Zayno/BitaxeFluxReview/_Manufacturing_Files/BitaxeFluxAstra_RevA_Manufacturing_BOM_updated.xlsx

Item | Reference Designators | Quantity | Value | Description | Manufacturer | Manufacturer Part Number | Package / Footprint | Mounting Type | Key Specification | LCSC Part Number | Digi-Key Part Number | Mouser Part Number | Lifecycle / Availability | Datasheet / Manufacturer Source | Notes | Supply Method / Consignment
1 | A1 | 1 | BM1373 | BM1373 ASIC | Bitmain | TBD – MANUAL VERIFICATION REQUIRED | BitaxeFluxAstra:BM1373 | SMD / thermal PTH-in-pad array | BM1373; custom 156-pad-object land pattern |  |  |  | Restricted/proprietary supply; approved source required | KiCad BOM / approved project design | ASSEMBLY INSTRUCTION: Customer will supply the BM1373 for placement at A1. Do not source or substitute this ASIC. Verify exact MPN, physical package/footprint, and received consignment inventory before scheduling assembly. | CONSIGNED - CUSTOMER SUPPLIED
2 | C2, C3, C8, C12, C24, C26, C38, C41, C49, C54, C55, C56, C57, C110, C111, C112, C113, C116, C117 | 19 | 10uF | Multilayer ceramic capacitor | Murata Electronics | GRM188R61E106KA73D | Capacitor_SMD:C_0603_1608Metric | SMD | 10µF ±10%, 25V, X5R, 0603 | C344022 | 490-18214-1-ND |  | Active; distributor listings verified | https://www.murata.com/en-us/products/productdetail?partno=GRM188R61E106KA73D | Original KiCad MPN and supplier identifiers retained; package/value/rating verified.
3 | C4, C16, C21, C27, C44, C45, C48, C199, C200 | 9 | 1uF | Multilayer ceramic capacitor | Taiyo Yuden | TMK107B7105KA-T | Capacitor_SMD:C_0603_1608Metric | SMD | 1µF ±10%, 25V, X7R, 0603 |  | 587-2984-1-ND |  | Active; distributor listing verified | https://www.digikey.com/en/products/result?keywords=TMK107B7105KA-T | Exact package and dielectric variant retained from KiCad BOM.
4 | C5, C31 | 2 | 4.7nF | Multilayer ceramic capacitor | Murata Electronics | GRM155R71E472KA01D | Capacitor_SMD:C_0402_1005Metric | SMD | 4.7nF ±10%, 25V, X7R, 0402 |  | 490-1309-1-ND |  | Active; manufacturer listing verified | https://www.murata.com/en-us/products/productdetail?partno=GRM155R71E472KA01D | Exact value, voltage, dielectric, and 0402 package verified.
5 | C6, C32 | 2 | 2.2nF | Multilayer ceramic capacitor | Murata Electronics | GRM155R61H222KA01D | Capacitor_SMD:C_0402_1005Metric | SMD | 2.2nF ±10%, 50V, X5R, 0402 |  | 490-8257-1-ND |  | Active; manufacturer listing verified | https://www.murata.com/en-us/products/productdetail?partno=GRM155R61H222KA01D | Original KiCad selection retained and verified.
6 | C7, C18, C33, C51, C52, C53, C92, C94 | 8 | 0.1uF | Multilayer ceramic capacitor | KYOCERA AVX | KGM05AR71C104KH | Capacitor_SMD:C_0402_1005Metric | SMD | 100nF ±10%, 16V, X7R, 0402 |  | 478-KGM05AR71C104KHCT-ND |  | Active; distributor listing verified | https://www.digikey.com/en/products/result?keywords=KGM05AR71C104KH | Original KiCad selection retained and verified.
7 | C9, C46 | 2 | 1000pF | Multilayer ceramic capacitor | Yageo | CC0805KRX7R9BB102 | Capacitor_SMD:C_0805_2012Metric | SMD | 1nF ±10%, 50V, X7R, 0805 |  | 311-1127-1-ND |  | Active; distributor listing verified | https://www.digikey.com/en/products/result?keywords=CC0805KRX7R9BB102 | Original KiCad selection retained and verified.
8 | C10, C11, C13, C14, C15, C102, C105, C107, C108, C109, C114, C115 | 12 | 100uF | Multilayer ceramic capacitor | Samsung Electro-Mechanics | CL31A107MQHNNNE | Capacitor_SMD:C_1206_3216Metric | SMD | 100µF ±20%, 6.3V, X5R, 1206 | C15008 | 1276-1782-1-ND |  | Active; distributor stock listed | https://www.digikey.com/en/products/detail/samsung-electro-mechanics/CL31A107MQHNNNE/3887440 | LCSC number completed from exact MPN; package/value/rating verified.
9 | C19, C40 | 2 | 4.7uF | Multilayer ceramic capacitor | Murata Electronics | GRM155R61A475MEAAD | Capacitor_SMD:C_0402_1005Metric | SMD | 4.7µF ±20%, 10V, X5R, 0402 |  | 490-14306-1-ND |  | Active; manufacturer/distributor listing verified | https://www.murata.com/en-us/products/productdetail?partno=GRM155R61A475MEAAD | Original KiCad selection retained and verified.
10 | C22, C37, C39, C42, C43 | 5 | 0.1uF | Multilayer ceramic capacitor | Murata Electronics | GRM155R71H104KE14D | Capacitor_SMD:C_0402_1005Metric | SMD | 100nF ±10%, 50V, X7R, 0402 | C77020 | 490-10700-1-ND |  | Active; manufacturer/distributor listing verified | https://www.murata.com/en-us/products/productdetail?partno=GRM155R71H104KE14D | Original KiCad MPN and supplier identifiers retained.
11 | C29, C30 | 2 | 33nF | Multilayer ceramic capacitor | Yageo | CC0402KRX7R9BB333 | Capacitor_SMD:C_0402_1005Metric | SMD | 33nF ±10%, 50V, X7R, 0402 | C106862 | 13-CC0402KRX7R9BB333CT-ND |  | Active; distributor listings verified | https://www.digikey.com/en/products/result?keywords=CC0402KRX7R9BB333 | Original KiCad selection retained and verified.
12 | C35, C36 | 2 | 22uF | Multilayer ceramic capacitor | Samsung Electro-Mechanics | CL21A226MPQNNNE | Capacitor_SMD:C_0805_2012Metric | SMD | 22µF ±20%, 10V, X5R, 0805 | C29277 | 1276-2910-1-ND |  | Active; distributor listings verified | https://www.digikey.com/en/products/result?keywords=CL21A226MPQNNNE | Original KiCad selection retained and verified.
13 | C47, C100, C103 | 3 | 33pF | Multilayer ceramic capacitor | KYOCERA AVX | KGM05ACG1E330JH | Capacitor_SMD:C_0402_1005Metric | SMD | 33pF ±5%, 25V, C0G/NP0, 0402 |  | 478-KGM05ACG1E330JHCT-ND |  | Active; distributor listing verified | https://www.digikey.com/en/products/result?keywords=KGM05ACG1E330JH | Original KiCad selection retained and verified.
14 | C63, C64, C65, C66, C67, C68, C69, C70, C71, C80, C81, C82, C83, C88, C89, C90 | 16 | 1uF | Multilayer ceramic capacitor | Taiyo Yuden | EMK105BJ105MV-F | Capacitor_SMD:C_0402_1005Metric | SMD | 1µF ±20%, 16V, X5R, 0402 | C2177690 | 587-5514-1-ND |  | Active; distributor listings verified | https://www.digikey.com/en/products/result?keywords=EMK105BJ105MV-F | Original KiCad selection retained and verified.
15 | C93 | 1 | 2.2nF C0G/NP0 | Precision multilayer ceramic capacitor | Murata Electronics | GRM1555C1H222JA01D | Capacitor_SMD:C_0402_1005Metric | SMD | 2.2nF ±5%, 50V, C0G/NP0, 0402 |  | 490-GRM1555C1H222JA01DCT-ND |  | Active; manufacturer/distributor listing verified | https://www.murata.com/en-us/products/productdetail?partno=GRM1555C1H222JA01D | Production MPN selected in place of original 'TBD / QUALIFY'; matches required value, C0G/NP0 dielectric, voltage class, tolerance, and footprint.
16 | C101 | 1 | 100pF | Multilayer ceramic capacitor | Yageo | CC0402JRNPO9BN101 | Capacitor_SMD:C_0402_1005Metric | SMD | 100pF ±5%, 50V, C0G/NP0, 0402 |  | 311-1024-1-ND |  | Active; distributor listing verified | https://www.digikey.com/en/products/result?keywords=CC0402JRNPO9BN101 | Original KiCad selection retained and verified.
17 | C104, C106 | 2 | 120uF | Conductive polymer hybrid aluminum capacitor | Nichicon | GYG1E121MCQ1GS | Capacitor_SMD:CP_Elec_6.3x5.9 | SMD polarized can | 120µF ±20%, 25V, 50mΩ ESR, 1.4A ripple, 6.3×5.8mm, 125°C |  | 493-GYG1E121MCQ1GSCT-ND |  | Mass production; active at Digi-Key | https://www.nichicon.com/en-us/part/gyg1e121mcq1gs/359/ | 25V GYG part selected to match the approved CAD requirement; 120µF, ±20%, 50mΩ ESR, 1.4A ripple, 6.3×5.8mm, 125°C. Footprint compatibility retained.
18 | FB1, FB2 | 2 | FerriteBead | Power-line ferrite bead | Murata Electronics | BLM31KN601SN1L | Capacitor_SMD:C_1206_3216Metric | SMD | 600Ω at 100MHz ±25%, 2.9A, 38mΩ max, 1206 | C668306 | 490-16533-1-ND | 81-BLM31KN601SN1L | Active; multiple distributor listings | https://www.murata.com/en-us/products/productdata/8801529331742/ENFA0091.pdf | Supplier identifiers completed from exact MPN.
19 | J1 | 1 | XT30UPB-M | XT30 vertical male PCB power connector | AMASS | XT30UPB-M | XT30UPB-M:AMASS_XT30UPB-M | THT | Male, vertical/straight PCB mount, 2 power contacts, 5.0mm pitch, 15A nominal | C428721 |  |  | Active/catalogued; LCSC/JLC listing verified | https://cdn.promelec.ru/upload/items/2025/03/25/AMASS_Catalogue_.pdf | Approved project connector identity applied consistently. Verify polarity marking and retention-hole plating in the assembly drawing before release.
20 | J2 | 1 | FPC-05F-30PH20 | 30-position FFC/FPC connector | XUNPU | FPC-05FB-30PH20 | BitaxeFluxAstra:FPC-SMD_30P-P0.50_XUNPU_FPC-05F-30PH20 | SMD, right-angle | 30 contacts, 0.5mm pitch, horizontal flip-lock, 0.3mm FFC, 50V/0.5A | C2856833 |  |  | In production; LCSC/JLC listing verified | https://www.xunpu.com.cn/product/413.html | The KiCad value/footprint label omits the 'B'; existing PARTNO FPC-05FB-30PH20 is the verified purchasable 30-pin 0.5mm right-angle part. No electrical grouping or connector substitution performed.
21 | J4 | 1 | USB_C_Receptacle_USB2.0 | USB Type-C receptacle for USB 2.0 | GCT | USB4105-GF-A | BitaxeFluxAstra:USB_C_Receptacle_GCT_USB4105-xx-A | SMD, top-mount | USB-C receptacle, USB 2.0, 16 contacts, horizontal mating |  | 2073-USB4105-GF-ACT-ND |  | Active; Digi-Key and Mouser listings verified | https://www.digikey.com/en/products/detail/gct/USB4105-GF-A/11198441 | Exact -GF-A suffix and footprint family retained.
22 | J7, J8, J9 | 3 | Conn_01x04 | 4-position fan/header connector | Molex | 0470531000 | BitaxeFluxAstra:470531000 | THT, vertical | 4 circuits, 2.54mm pitch, vertical male header with friction lock |  | WM4330-ND |  | Active; manufacturer/distributor listing verified | https://www.molex.com/content/dam/molex/molex-dot-com/products/automated/en-us/salesdrawingpdf/470/47053/470531000_sd.pdf | Connector position count, pitch, orientation, and THT mounting verified.
23 | L1, L4 | 2 | 270nH | High-current shielded power inductor | Coilcraft | SLC1175-271MEC | BitaxeFluxAstra:SLC1175-271MEC_COC | SMD | 270nH ±20%, shielded, 35.5A current rating, SLC1175 package |  |  | 994-SLC1175-271MEC | Active; manufacturer/Mouser listing verified | https://www.coilcraft.com/en-us/products/power/shielded-inductors/low-dcr/slc/slc1175/ | Exact 270nH MPN and custom footprint retained.
24 | L2, L3 | 2 | 1.5uH | Shielded power inductor | cjiang (Changjiang Microelectronics Technology) | FTC201612S1R5MBCA | BitaxeFluxAstra:IND-SMD_L2.0-W1.6 | SMD | 1.5µH ±20%, 4A, 40mΩ, 2.0×1.6mm | C5832350 |  |  | Active/in stock at LCSC | https://www.lcsc.com/product-detail/Power-Inductors_cjiang-Changjiang-Microelectronics-Tech-FTC201612S1R5MBCA_C5832350.html | Exact MPN, value, current rating, and land size verified.
25 | R1, R10 | 2 | 49.9 | Thick-film chip resistor | Yageo | RC0402FR-0749R9L | Resistor_SMD:R_0402_1005Metric | SMD | 49.9Ω ±1%, 0.063W, 0402 |  | 311-49.9LRCT-ND |  | Active; distributor listing verified | https://www.digikey.com/en/products/result?keywords=RC0402FR-0749R9L | Original KiCad selection retained and verified.
26 | R2, R21 | 2 | 1 | High-power chip resistor | ROHM Semiconductor | ESR10EZPJ1R0 | Resistor_SMD:R_0805_2012Metric | SMD | 1Ω ±5%, high-power ESR10 series, 0805 |  | RHM1KTR-ND |  | Active; distributor listing verified | https://www.digikey.com/en/products/result?keywords=ESR10EZPJ1R0 | Exact ROHM ESR10 package/value variant retained.
27 | R3, R19 | 2 | 10 | Thick-film chip resistor | Yageo | RC0402FR-0710RL | Resistor_SMD:R_0402_1005Metric | SMD | 10Ω ±1%, 0.063W, 0402 |  | 311-10.0LRCT-ND |  | Active; distributor listing verified | https://www.digikey.com/en/products/result?keywords=RC0402FR-0710RL | Original KiCad selection retained and verified.
28 | R5, R6, R13, R16, R20, R24, R30, R37, R38, R40, R57 | 11 | 10k | Thick-film chip resistor | Yageo | RC0402FR-0710KL | Resistor_SMD:R_0402_1005Metric | SMD | 10kΩ ±1%, 0.063W, 0402 | C60490 | 311-10.0KLRCT-ND |  | Active; distributor listings verified | https://www.digikey.com/en/products/detail/yageo/RC0402FR-0710KL/729470 | Updated supplier identifiers to match the approved Yageo RC0402FR-0710KL 10kΩ ±1% 0402 selection; includes R37.
29 | R12 | 1 | 30.9k | Thick-film chip resistor | Yageo | RC0402FR-0730K9L | Resistor_SMD:R_0402_1005Metric | SMD | 30.9kΩ ±1%, 0.063W, 0402 | C185428 | YAG3110CT-ND |  | Active; distributor listings verified | https://www.digikey.com/en/products/result?keywords=RC0402FR-0730K9L | Original KiCad selection retained and verified.
30 | R14, R25 | 2 | 5.1k | Thick-film chip resistor | Stackpole Electronics | RMCF0402JT5K10 | Resistor_SMD:R_0402_1005Metric | SMD | 5.1kΩ ±5%, 0.063W, 0402 | C2481753 | RMCF0402JT5K10CT-ND |  | Active; distributor listings verified | https://www.digikey.com/en/products/result?keywords=RMCF0402JT5K10 | Original KiCad selection retained and verified.
31 | R15 | 1 | 13.7k | Thick-film chip resistor | Yageo | RC0402FR-0713K7L | Resistor_SMD:R_0402_1005Metric | SMD | 13.7kΩ ±1%, 0.063W, 0402 | C274888 | 311-13.7KLRCT-ND |  | Active; distributor listings verified | https://www.digikey.com/en/products/result?keywords=RC0402FR-0713K7L | Original KiCad selection retained and verified.
32 | R17 | 1 | 52.3k | Thick-film chip resistor | Yageo | RC0402FR-0752K3L | Resistor_SMD:R_0402_1005Metric | SMD | 52.3kΩ ±1%, 0.063W, 0402 |  | YAG3179CT-ND |  | Active; distributor listing verified | https://www.digikey.com/en/products/result?keywords=RC0402FR-0752K3L | Original KiCad selection retained and verified.
33 | R23 | 1 | 20k | Thick-film chip resistor | Yageo | RC0402FR-0720KL | Resistor_SMD:R_0402_1005Metric | SMD | 20kΩ ±1%, 0.063W, 0402 |  | 311-20.0KLRCT-ND |  | Active; distributor listing verified | https://www.digikey.com/en/products/result?keywords=RC0402FR-0720KL | Original KiCad selection retained and verified.
34 | R26, R48 | 2 | 1k | Thick-film chip resistor | Yageo | RC0402FR-071KL | Resistor_SMD:R_0402_1005Metric | SMD | 1kΩ ±1%, 0.063W, 0402 |  | 311-1.00KLRCT-ND |  | Active; distributor listing verified | https://www.digikey.com/en/products/result?keywords=RC0402FR-071KL | Original KiCad selection retained and verified.
35 | R29, R32, R49, R56 | 4 | 0 | Zero-ohm chip jumper | Yageo | RC0402JR-070RL | Resistor_SMD:R_0402_1005Metric | SMD | 0Ω jumper, 0.063W, 0402 |  | 311-0.0JRCT-ND |  | Active; distributor listing verified | https://www.digikey.com/en/products/result?keywords=RC0402JR-070RL | R49 added as the populated CORE_EN 0Ω link; same Yageo RC0402JR-070RL 0402 jumper used by the existing group.
36 | R31 | 1 | 5.6k | Thick-film chip resistor | Yageo | RC0402FR-075K6L | Resistor_SMD:R_0402_1005Metric | SMD | 5.6kΩ ±1%, 0.063W, 0402 |  | 311-5.6KLRCT-ND |  | Active; distributor listing verified | https://www.digikey.com/en/products/result?keywords=RC0402FR-075K6L | Original KiCad selection retained and verified.
37 | R39 | 1 | 4.7k | Thick-film chip resistor | Yageo | RC0402JR-074K7L | Resistor_SMD:R_0402_1005Metric | SMD | 4.7kΩ ±5%, 0.063W, 0402 |  | 311-4.7KJRCT-ND |  | Active; distributor listing verified | https://www.digikey.com/en/products/result?keywords=RC0402JR-074K7L | Original KiCad selection retained and verified.
38 | R45, R47 | 2 | 4.7k | Precision thick-film chip resistor | Yageo | RC0402DR-074K7L | Resistor_SMD:R_0402_1005Metric | SMD | 4.7kΩ ±0.5%, 0.063W, 0402 | C471788 | 13-RC0402DR-074K7LCT-ND |  | Active; availability should be checked at release | https://www.digikey.com/en/products/detail/yageo/RC0402DR-074K7L/5917421 | Corrected selection: original MPN RC0402DR-0710KL and LCSC C471764 are 10kΩ and do not match the 4.7kΩ schematic value. Replacement preserves the DR 0.5% tolerance class and 0402 package.
39 | R58, R59 | 2 | 22 | Thick-film chip resistor | Yageo | RC0402FR-0722RL | Resistor_SMD:R_0402_1005Metric | SMD | 22Ω ±1%, 0.063W, 0402 |  |  |  | Active; manufacturer/distributor listing verified | https://www.digikey.com/en/products/result?keywords=RC0402FR-0722RL | USB series resistors; exact value/package MPN verified.
40 | SW1, SW2 | 2 | SW_Push_SPST_NO | Momentary tactile switch | CIT Relay and Switch | CS1213AGF260 | BitaxeFluxAstra:SW_CS1213AGF260_CRS | SMD, top-actuated | SPST-NO, momentary, 50mA at 50VDC, 260gf | C5578986 | 2449-CS1213AGF260CT-ND |  | Active; distributor listings verified | https://www.digikey.com/en/products/detail/cit-relay-and-switch/CS1213AGF260/16607763 | Exact actuator force, contact form, and footprint family verified.
41 | U2 | 1 | SN74AXC4T774 | 4-bit dual-supply level translator | Texas Instruments | SN74AXC4T774PWR | Package_SO:TSSOP-16_4.4x5mm_P0.65mm | SMD | 4-channel direction-controlled translator, 0.65mm TSSOP-16 | C1849453 | 296-SN74AXC4T774PWRCT-ND |  | Active; TI product status verified | https://www.ti.com/product/SN74AXC4T774 | Exact PWR TSSOP-16 suffix and pin-count compatibility verified.
42 | U3, U7 | 2 | TPS546D24S | 40A PMBus synchronous buck power stage/controller | Texas Instruments | TPS546D24SRVFR | BitaxeFluxAstra:LQFN40-CLIP | SMD | 2.95–16V input, 40A, PMBus, RVF LQFN-CLIP 40-pin |  | 296-TPS546D24SRVFRCT-ND |  | Active; TI product status verified | https://www.ti.com/product/TPS546D24S/part-details/TPS546D24SRVFR | Exact RVFR package/tape suffix and custom footprint pin count verified.
43 | U4, U5 | 2 | TPS62933DRLR | 3A synchronous step-down converter | Texas Instruments | TPS62933DRLR | BitaxeFluxAstra:SOT-583-8_L2.1-W1.2-P0.50-LS1.6-BR | SMD | 3.8–30V input, 3A, fixed-frequency buck, SOT-583 8-pin | C3200405 | 296-TPS62933DRLRCT-ND |  | Active; TI product status verified | https://www.ti.com/product/TPS62933/part-details/TPS62933DRLR | Exact DRLR SOT-583-8 package variant verified.
44 | U6 | 1 | ESP32-S3-WROOM-1-N16R8 | Wi-Fi/Bluetooth LE MCU module | Espressif Systems | ESP32-S3-WROOM-1-N16R8 | BitaxeFluxAstra:ESP32-S3-WROOM-1 | SMD module | ESP32-S3 module, 16MB flash, 8MB octal PSRAM, PCB antenna |  | 5407-ESP32-S3-WROOM-1-N16R8TR-ND |  | Active; manufacturer documentation verified | https://documentation.espressif.com/esp32-s3-wroom-1_wroom-1u_datasheet_en.pdf | Exact N16R8 memory variant and PCB-antenna module footprint verified.
45 | U8 | 1 | 25MHz | CMOS oscillator | Shenzhen SCTF Electronics | SX3M25.000E20F30THN | BitaxeFluxAstra:SMD3225-4P | SMD | 25MHz, 1.2V, CMOS, ±20ppm initial, 3.2×2.5mm 4-pad | C5137262 | 5852-SX3M25.000E20F30THNTR-ND |  | Active/stocked distributor listings verified | https://www.digikey.com/en/products/detail/shenzhen-sctf-electronics/SX3M25-000E20F30THN/25573861 | Exact frequency, supply variant, output type, and 3225 package verified.
46 | U10 | 1 | TLV77308PDBVR | 300mA low-dropout regulator | Texas Instruments | TLV77308PDBVR | Package_TO_SOT_SMD:SOT-23-5 | SMD | Fixed 0.8V output, 300mA, SOT-23-5 |  | 296-TLV77308PDBVRCT-ND |  | Active; TI product status verified | https://www.ti.com/product/TLV773/part-details/TLV77308PDBVR | Exact 0.8V PDBVR fixed-output variant verified.
47 | U11 | 1 | TLV77312PDBVR | 300mA low-dropout regulator | Texas Instruments | TLV77312PDBVR | Package_TO_SOT_SMD:SOT-23-5 | SMD | Fixed 1.2V output, 300mA, SOT-23-5 |  | 296-TLV77312PDBVRCT-ND |  | Active; TI product status verified | https://www.ti.com/product/TLV773/part-details/TLV77312PDBVR | Exact 1.2V PDBVR fixed-output variant verified.
48 | U13 | 1 | EMC2103-2-AP-TR | Fan controller and remote temperature monitor | Microchip Technology | EMC2103-2-AP-TR | Package_DFN_QFN:QFN-16-1EP_4x4mm_P0.65mm_EP2.1x2.1mm | SMD | SMBus fan controller, remote-diode monitor, QFN-16 exposed pad |  | 150-EMC2103-2-AP-CT-ND |  | In production; manufacturer datasheet verified | https://ww1.microchip.com/downloads/en/DeviceDoc/20005250.pdf | Exact -2-AP-TR electrical/package variant and QFN-16 pin count verified.
49 | U16 | 1 | AP2502KTR-G1 | Four-channel constant-current LED sink | Diodes Incorporated | AP2502KTR-G1 | Package_TO_SOT_SMD:SOT-23-6 | SMD | 4-channel constant-current sink, SOT-23-6, -40°C to +85°C |  | AP2502KTR-G1DICT-ND |  | Active; manufacturer product page verified | https://www.diodes.com/part/view/AP2502 | Exact KTR-G1 SOT-23-6 suffix retained and verified.
50 | R51 | 1 | 31.6k | Thick-film chip resistor | Yageo | RC0402FR-0731K6L | Resistor_SMD:R_0402_1005Metric | SMD | 31.6kΩ ±1%, 0.063W, 0402 | C276265 | YAG3115CT-ND |  | Active; distributor listings verified | https://www.digikey.com/en/products/detail/yageo/RC0402FR-0731K6L/5281980 | Populated U3 VSEL programming resistor from U3_VSEL to AGND1 for the approved 1.00V nominal core boot target.
