Zayno/BitaxeFluxReview/_KiCad_Project/3d/XT30PW-M--3DModel-STEP-269445.STEP

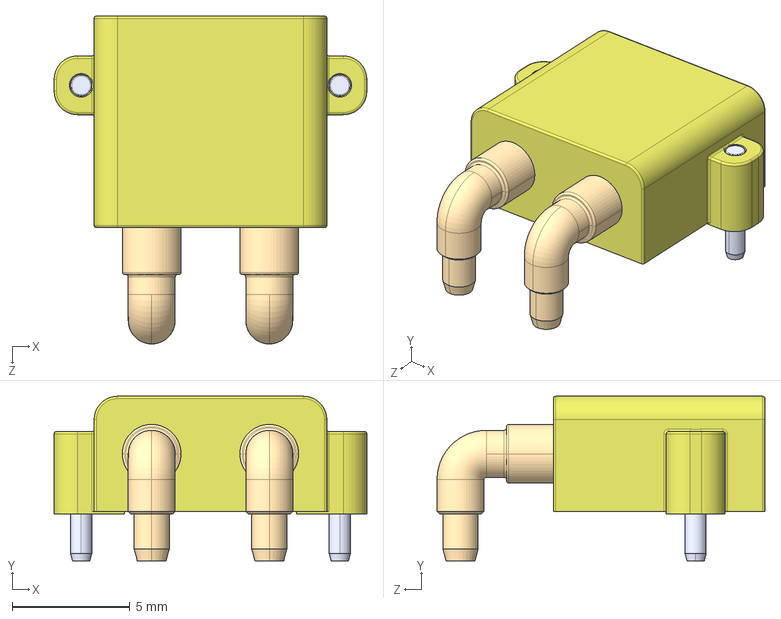
[picture p1: CAD file, 2026-10-25]
_KiCad_Project/3d/XT30PW-M--3DModel-STEP-269445.STEP
13.3 x 7.00 x 14.0 mm
