Zayno/BitaxeFluxReview/_KiCad_Project/BitaxeFluxAstra.step

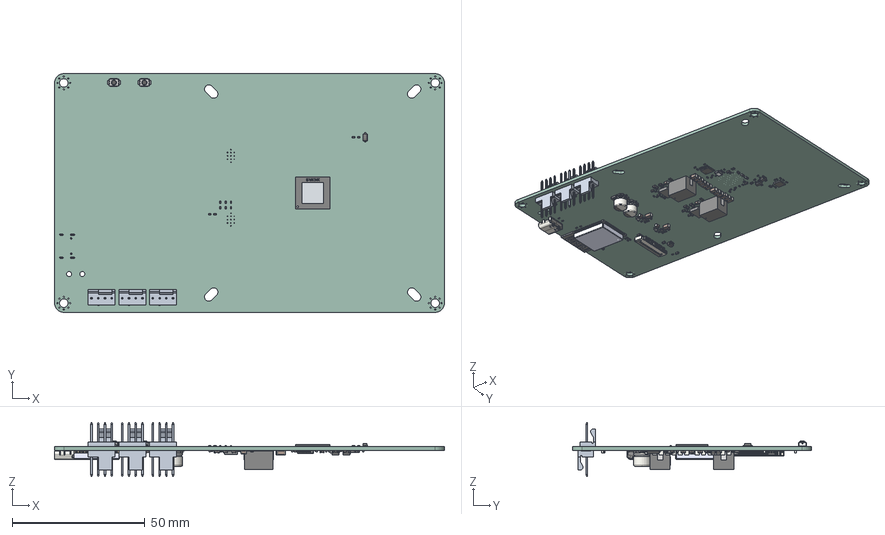
[picture p2: CAD file, 2026-10-25]
_KiCad_Project/BitaxeFluxAstra.step
147.0 x 90.0 x 20.5 mm
D_SOD_123F
R_0402_1005Metric x 42
Sketch002
Sketch003
C_1206_3216Metric x 14
C_0603_1608Metric x 28
C_0402_1005Metric x 44
C_0805_2012Metric x 4
SOT-583-8_L2.1-W1.2-P0.50-LS1.6-BR x 2
ECS-327KE
IND-SMD_L2.0-W1.6-H1.1 x 2
TSSOP-16_4.4x5mm_P0.65mm
RVF40 x 2
R_0805_2012Metric x 2
CP_Elec_63x59 x 2
SOT-23-6
SOT-23-5 x 2
USB_C_Receptacle_16P_TopMnt_Horizontal_GCT_USB4105-xx-A
ESP32-S3-WROOM-1-N8R2
QFN-16-1EP_4x4mm_P0.65mm_EP2.1x2.1mm
FPC-SMD_30P-P0.50_XUNPU_FPC-05F-30PH20
Bit9F3C_PCB
