Zayno/BitaxeFluxReview/_KiCad_Project/3d/SOT-583-8_L2.1-W1.2-P0.50-LS1.6-BR.step

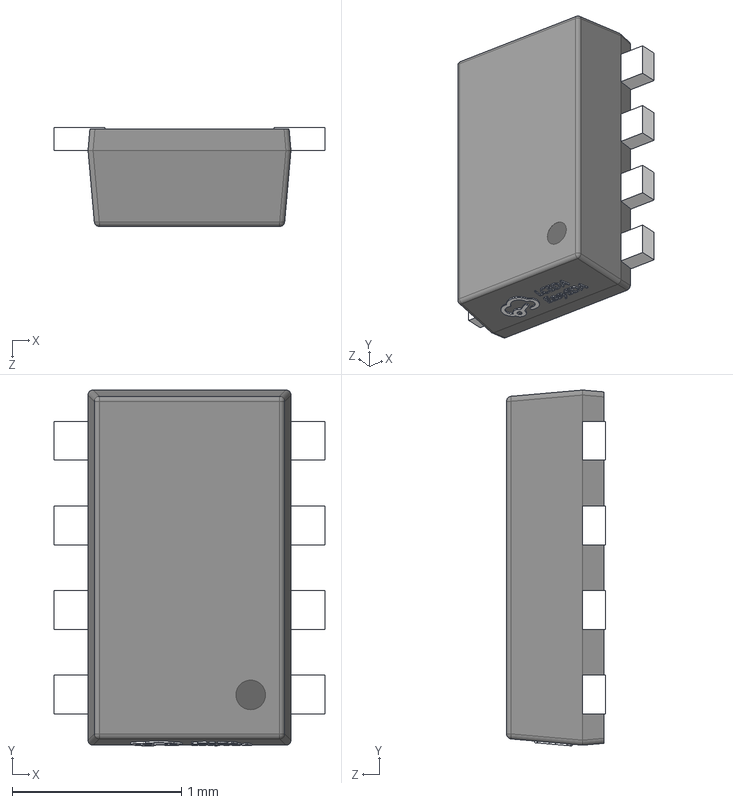
[picture p3: CAD file, 2026-10-25]
_KiCad_Project/3d/SOT-583-8_L2.1-W1.2-P0.50-LS1.6-BR.step
1.60 x 2.10 x 0.585 mm
