Zayno/BitaxeFluxReview/_KiCad_Project/3d/TPS546D24ARVFR.step

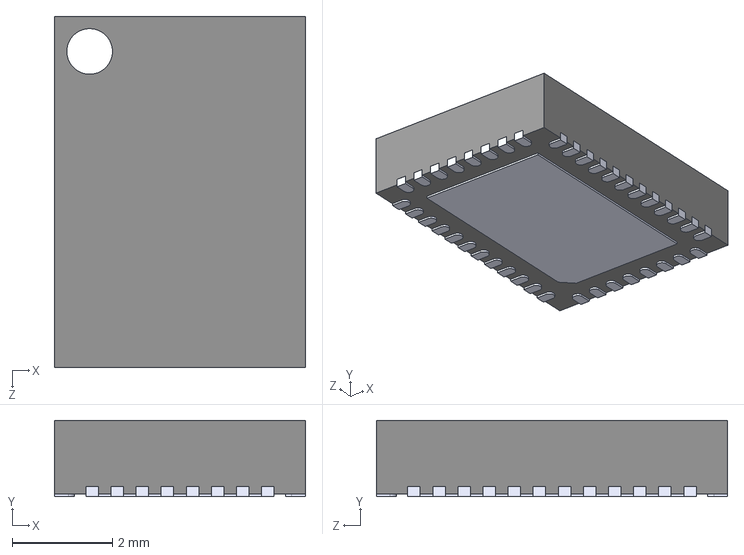
[picture p4: CAD file, 2026-10-25]
_KiCad_Project/3d/TPS546D24ARVFR.step
5.00 x 1.52 x 7.00 mm
