Zayno/BitaxeFluxReview/_KiCad_Project/3d/IND-SMD_L2.0-W1.6-H1.1.step

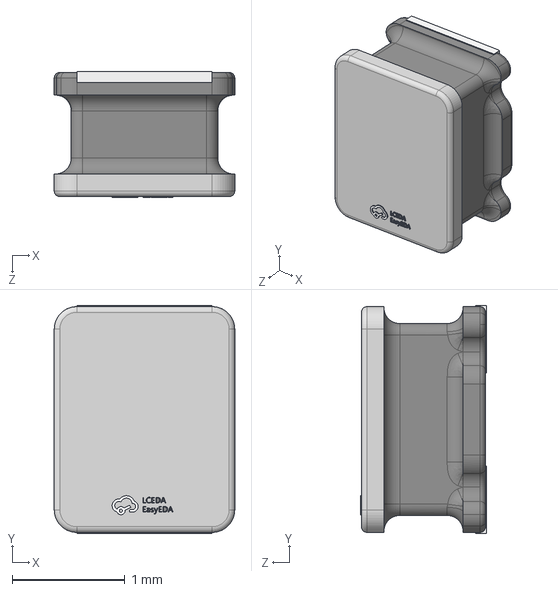
[picture p5: CAD file, 2026-10-25]
_KiCad_Project/3d/IND-SMD_L2.0-W1.6-H1.1.step
1.60 x 2.02 x 1.12 mm
