Zayno/BitaxeFluxReview/_KiCad_Project/3d/XT30UPB-M--3DModel-STEP-510211.STEP

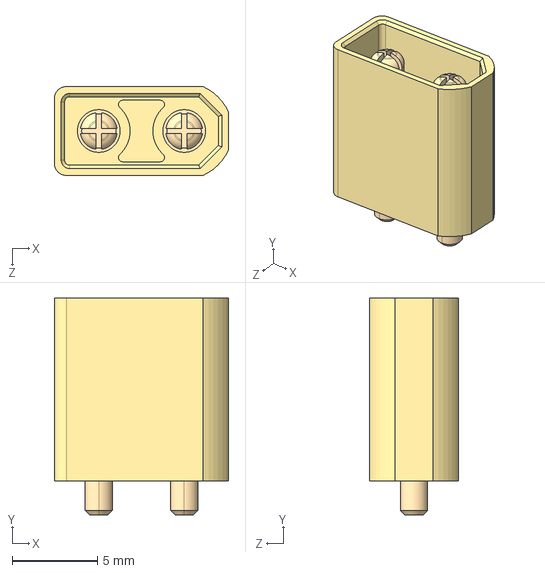
[picture p6: CAD file, 2026-10-25]
_KiCad_Project/3d/XT30UPB-M--3DModel-STEP-510211.STEP
10.2 x 12.7 x 5.20 mm
