Zayno/BitaxeFluxReview/_KiCad_Project/3d/FPC-SMD_30P-P0.50_XUNPU_FPC-05F-30PH20.step

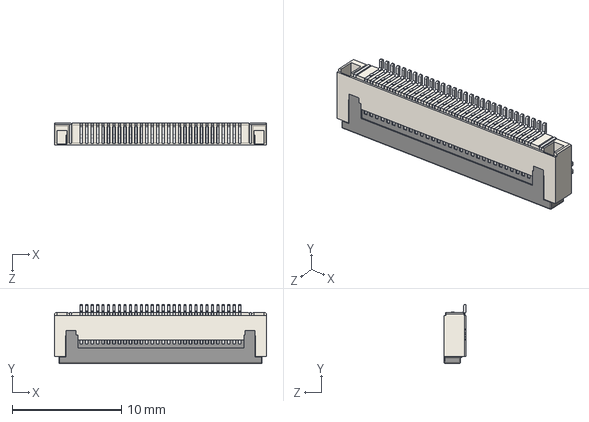
[picture p7: CAD file, 2026-10-25]
_KiCad_Project/3d/FPC-SMD_30P-P0.50_XUNPU_FPC-05F-30PH20.step
19.4 x 5.40 x 2.00 mm
