Zayno/BitaxeFluxReview/_KiCad_Project/3d/BM1373.step

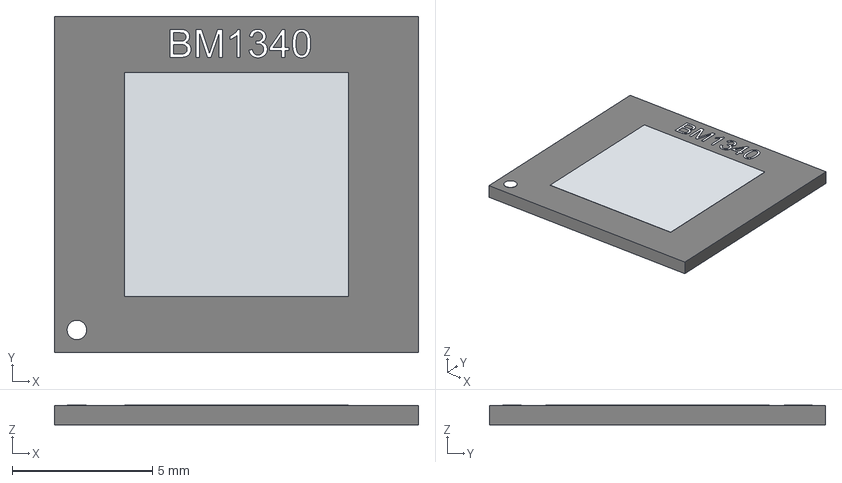
[picture p8: CAD file, 2026-10-25]
_KiCad_Project/3d/BM1373.step
13.0 x 12.0 x 0.71 mm
Sketch002
Sketch003
