Zayno/BitaxeFluxReview/_KiCad_Project/3d/CS1213AG-tr.stp

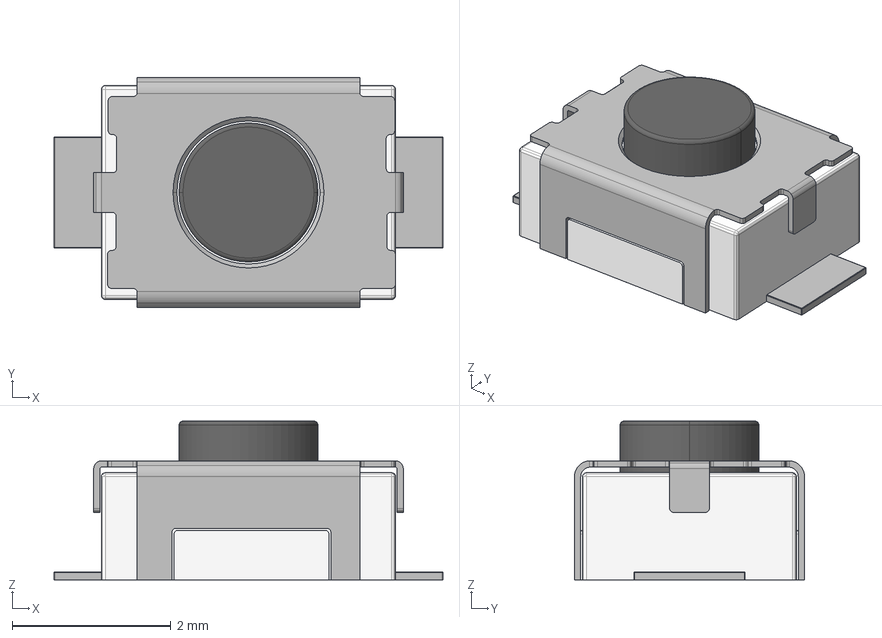
[picture p9: CAD file, 2026-10-25]
_KiCad_Project/3d/CS1213AG-tr.stp
4.90 x 2.90 x 2.00 mm
