Zayno/BitaxeFluxReview/_KiCad_Project/3d/oscillator3.2x2.5.step

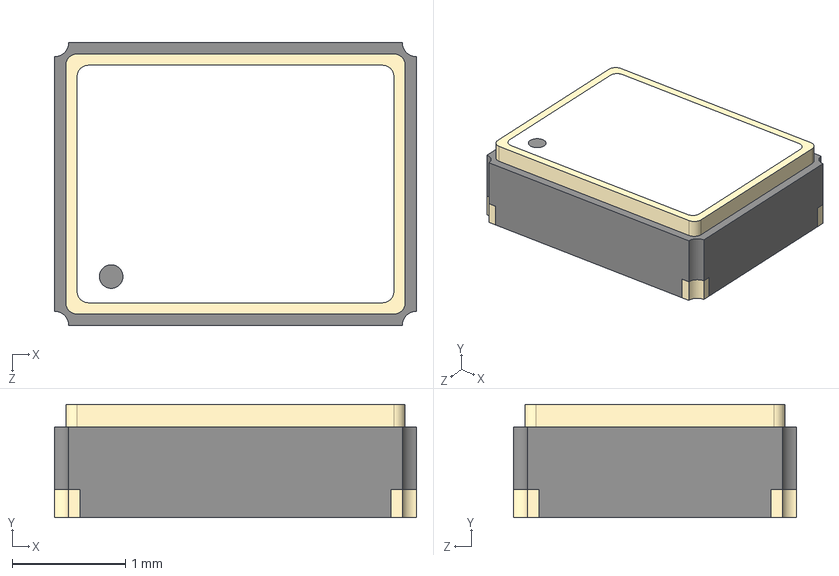
[picture p10: CAD file, 2026-10-25]
_KiCad_Project/3d/oscillator3.2x2.5.step
3.20 x 1.00 x 2.50 mm
