Zayno/BitaxeFluxReview/_KiCad_Project/3d/470531000.stp

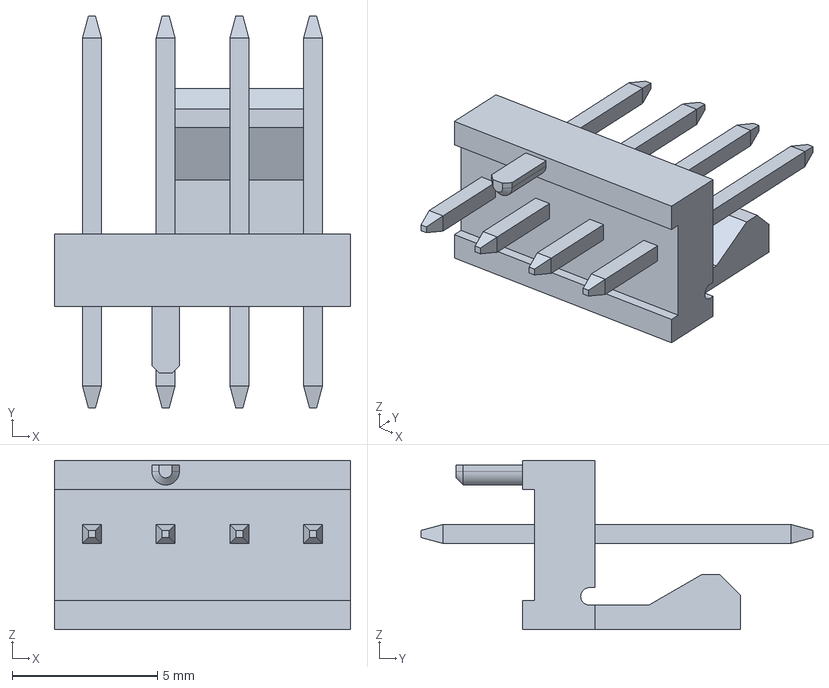
[picture p12: CAD file, 2026-10-25]
_KiCad_Project/3d/470531000.stp
10.2 x 13.5 x 5.84 mm
