Zayno/BitaxeFluxReview/_KiCad_Project/pdf/BitaxeFluxAstra.pdf

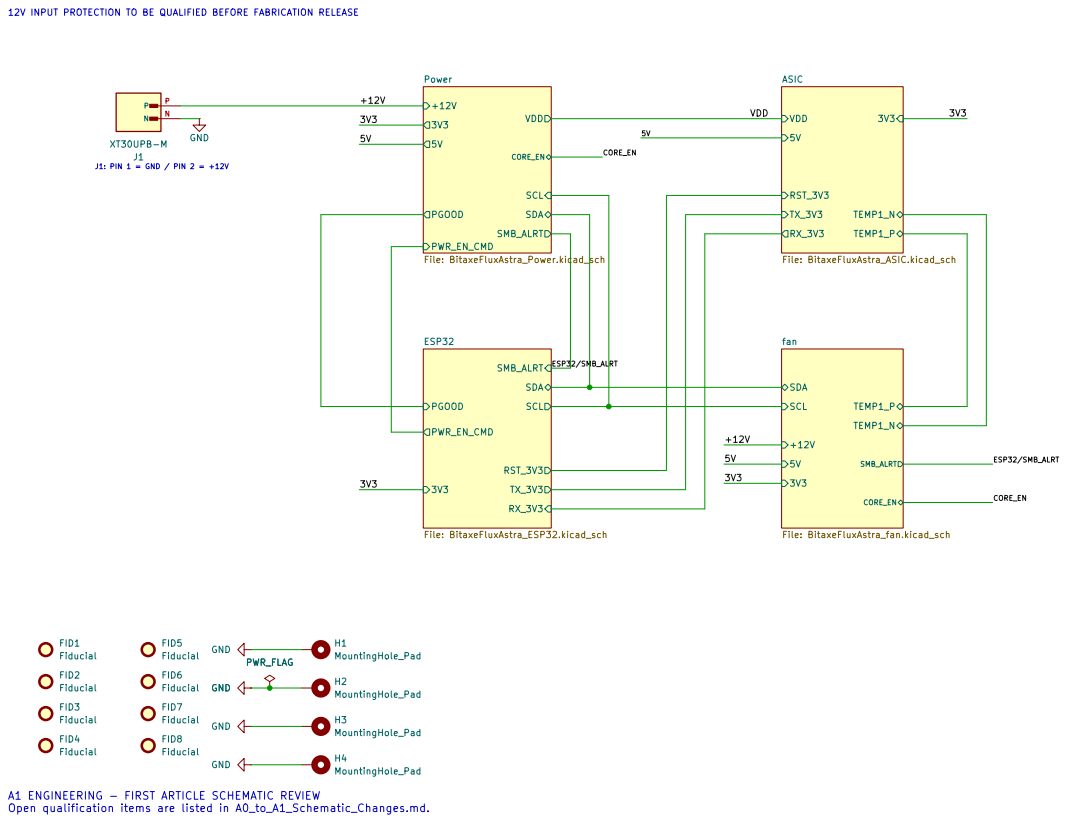
[picture p13: page 1]

J1: PIN 1 = GND / PIN 2 = +12V A1 ENGINEERING - FIRST ARTICLE SCHEMATIC REVIEW

12V INPUT PROTECTION TO BE QUALIFIED BEFORE FABRICATION RELEASE

File: BitaxeFluxAstra_fan.kicad_sch SDA SCL SMB_ALRT PGOOD

Open qualification items are listed in A0_to_A1_Schematic_Changes.md.

A1 ENGINEERING - FIRST ARTICLE SCHEMATIC REVIEW
bitaxeorg
Sheet: /
File: BitaxeFluxAstra.kicad_sch
Title: Bitaxe Flux Astra

Size: A3 | Rev: RevA | F Date: 2026-09-20
KiCad E.D.A. 10.0.5 | Id: 1/5

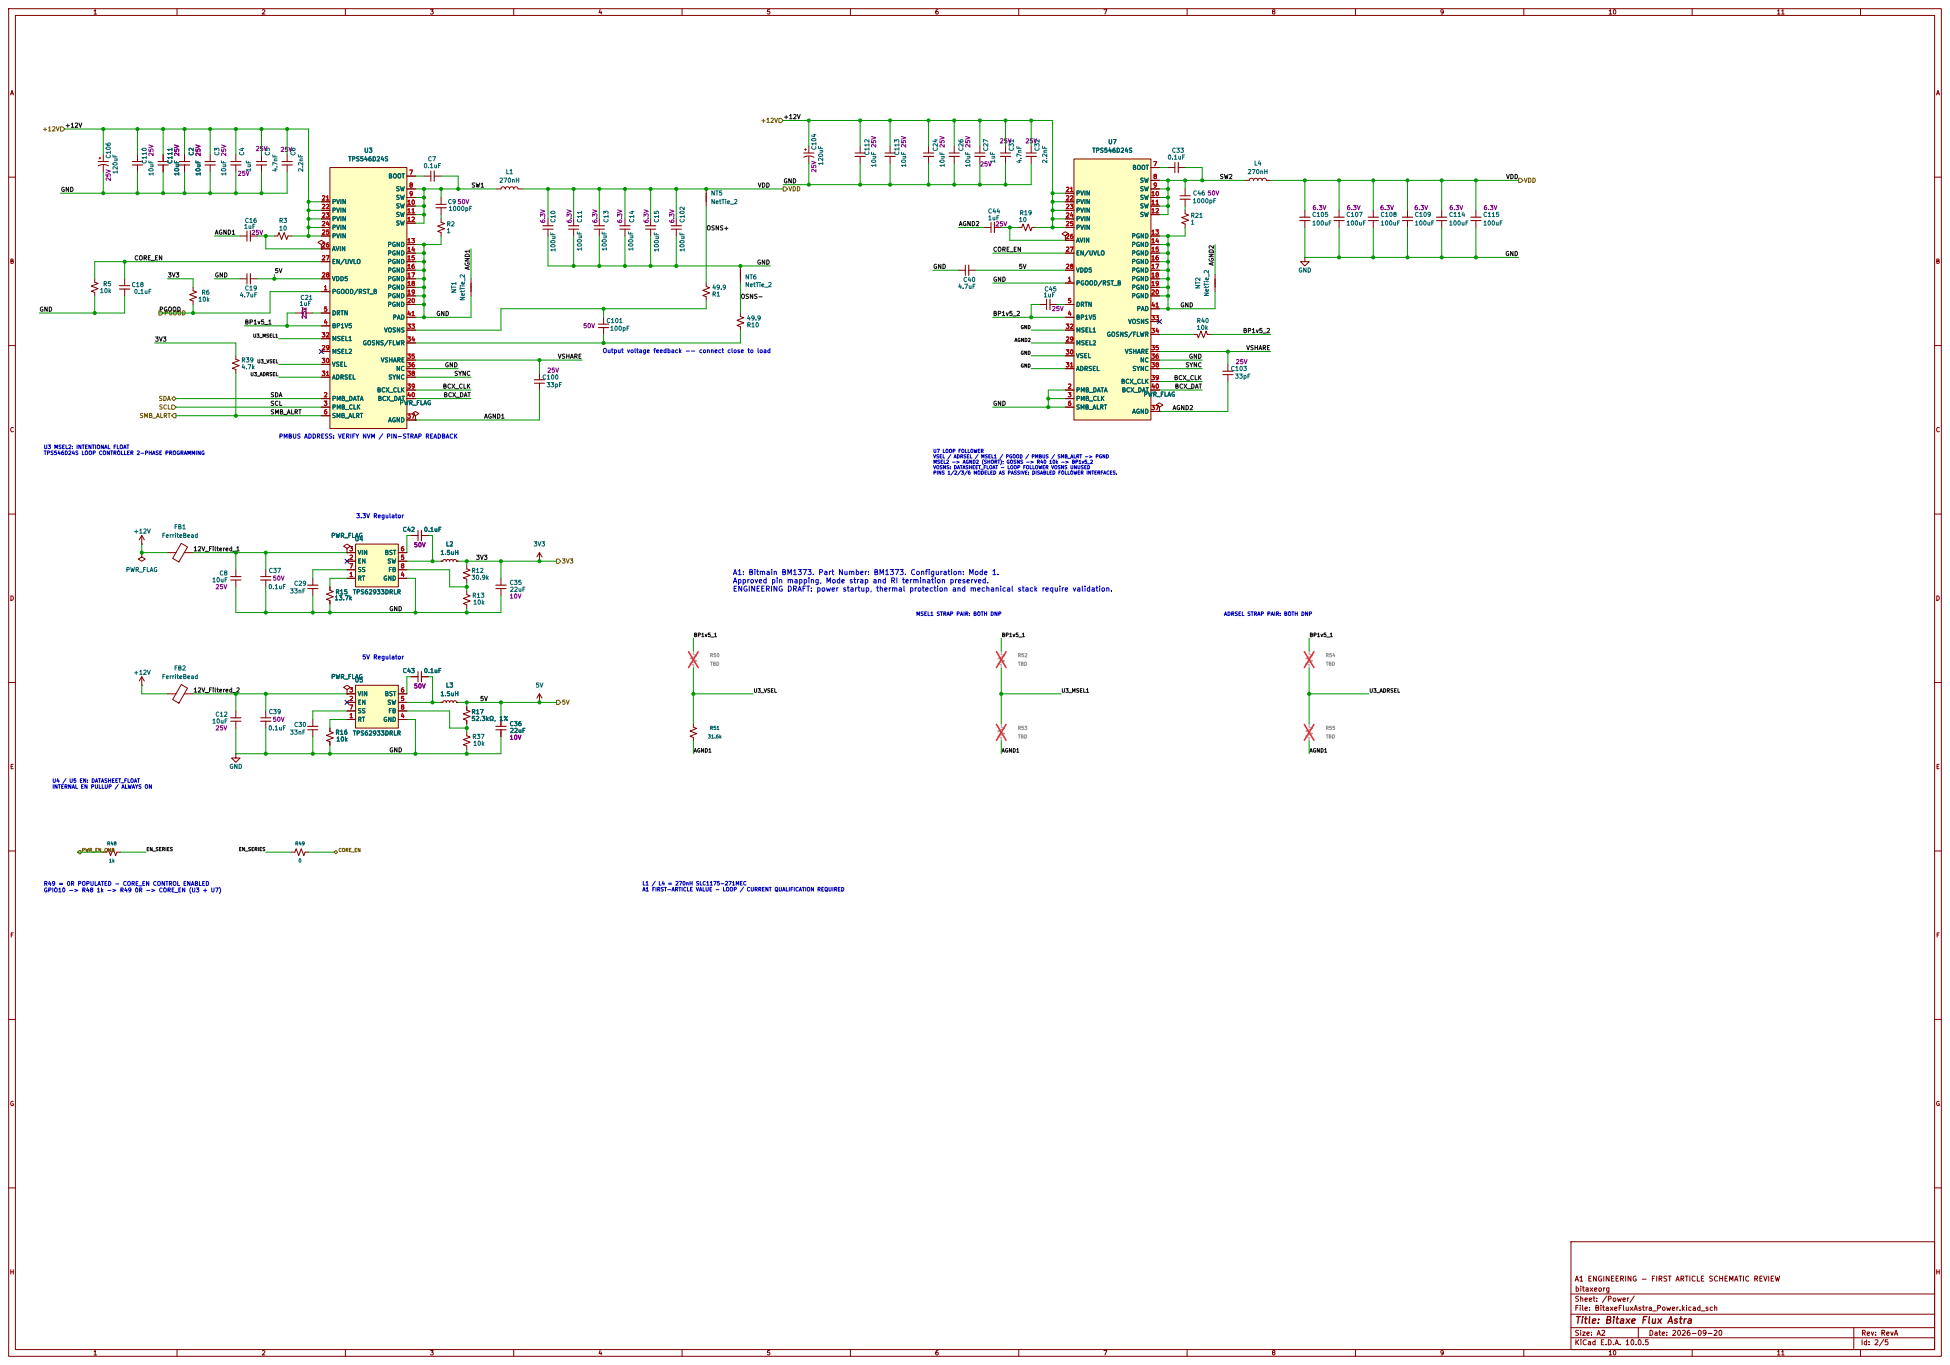
[picture p14: page 2]

SW 12 PGND 13 PGND 14 PGND 15 PGND 16 PGND 17 PGND 18 PGND 19 PGND 20 PVIN 21 PVIN 22 PVIN 23 PVIN 24 PVIN 25
GND CORE_EN

U3 MSEL2: INTENTIONAL FLOAT
TPS546D24S LOOP CONTROLLER 2-PHASE PROGRAMMING

U7 LOOP FOLLOWER
VSEL / ADRSEL / MSEL1 / PGOOD / PMBUS / SMB_ALRT -> PGND MSEL2 -> AGND2 (SHORT); GOSNS -> R40 10k -> BP1v5_2

VOSNS: DATASHEET_FLOAT - LOOP FOLLOWER VOSNS UNUSED

ENGINEERING DRAFT: power startup, thermal protection and mechanical stack require validation. U4
VIN 3

Approved pin mapping, Mode strap and RI termination preserved.

GPIO10 -> R48 1k -> R49 0R -> CORE_EN (U3 + U7) U4 / U5 EN: DATASHEET_FLOAT
INTERNAL EN PULLUP / ALWAYS ON

L1 / L4 = 270nH SLC1175-271MEC
A1 FIRST-ARTICLE VALUE - LOOP / CURRENT QUALIFICATION REQUIRED

A1 ENGINEERING - FIRST ARTICLE SCHEMATIC REVIEW
bitaxeorg
Sheet: /Power/
File: BitaxeFluxAstra_Power.kicad_sch

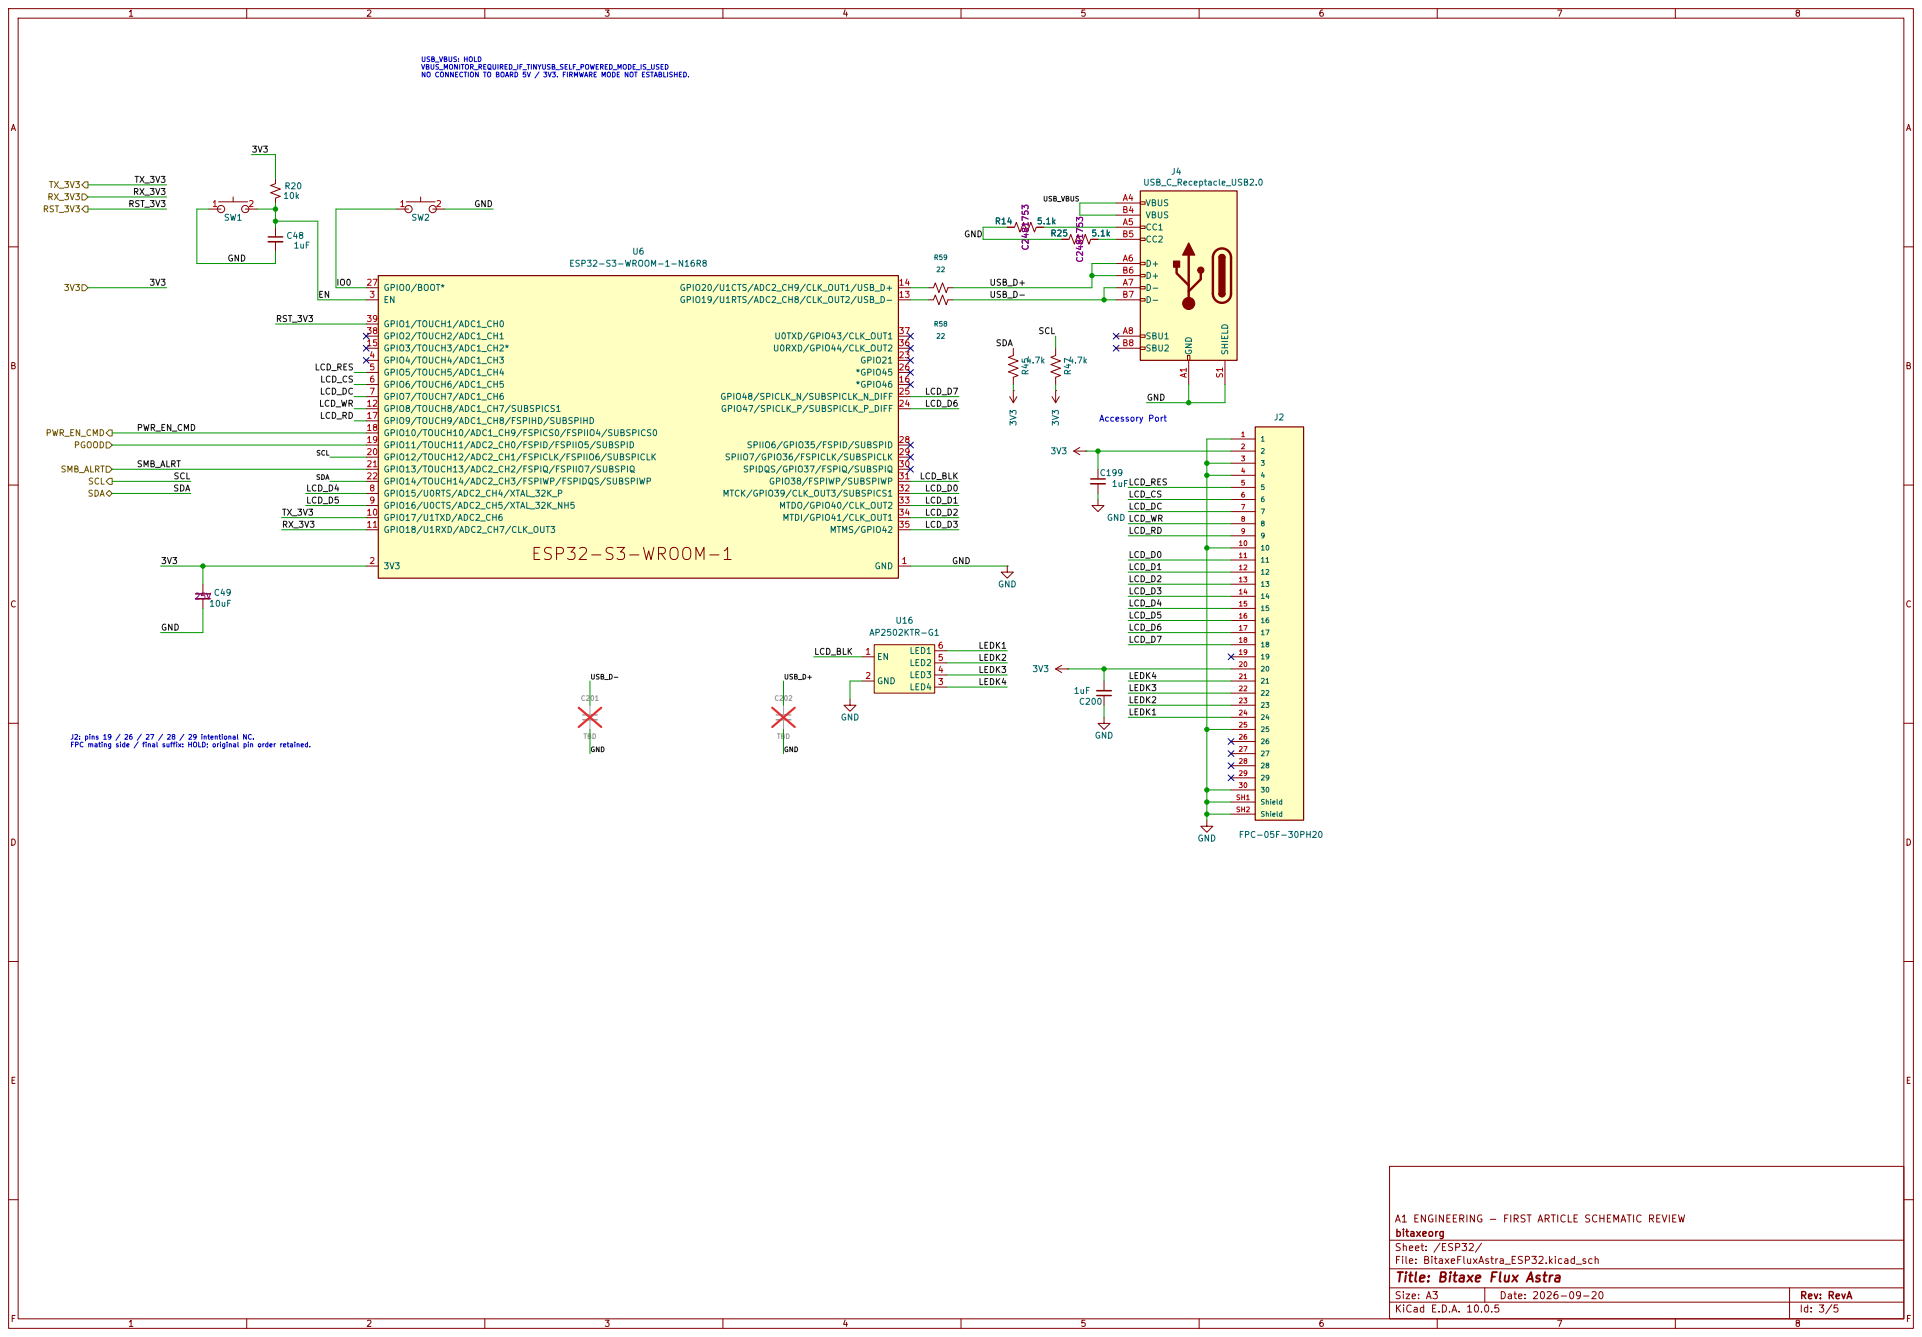
[picture p15: page 3]

A1 ENGINEERING - FIRST ARTICLE SCHEMATIC REVIEW GND A1

J2: pins 19 / 26 / 27 / 28 / 29 intentional NC. FPC mating side / final suffix: HOLD; original pin order retained.

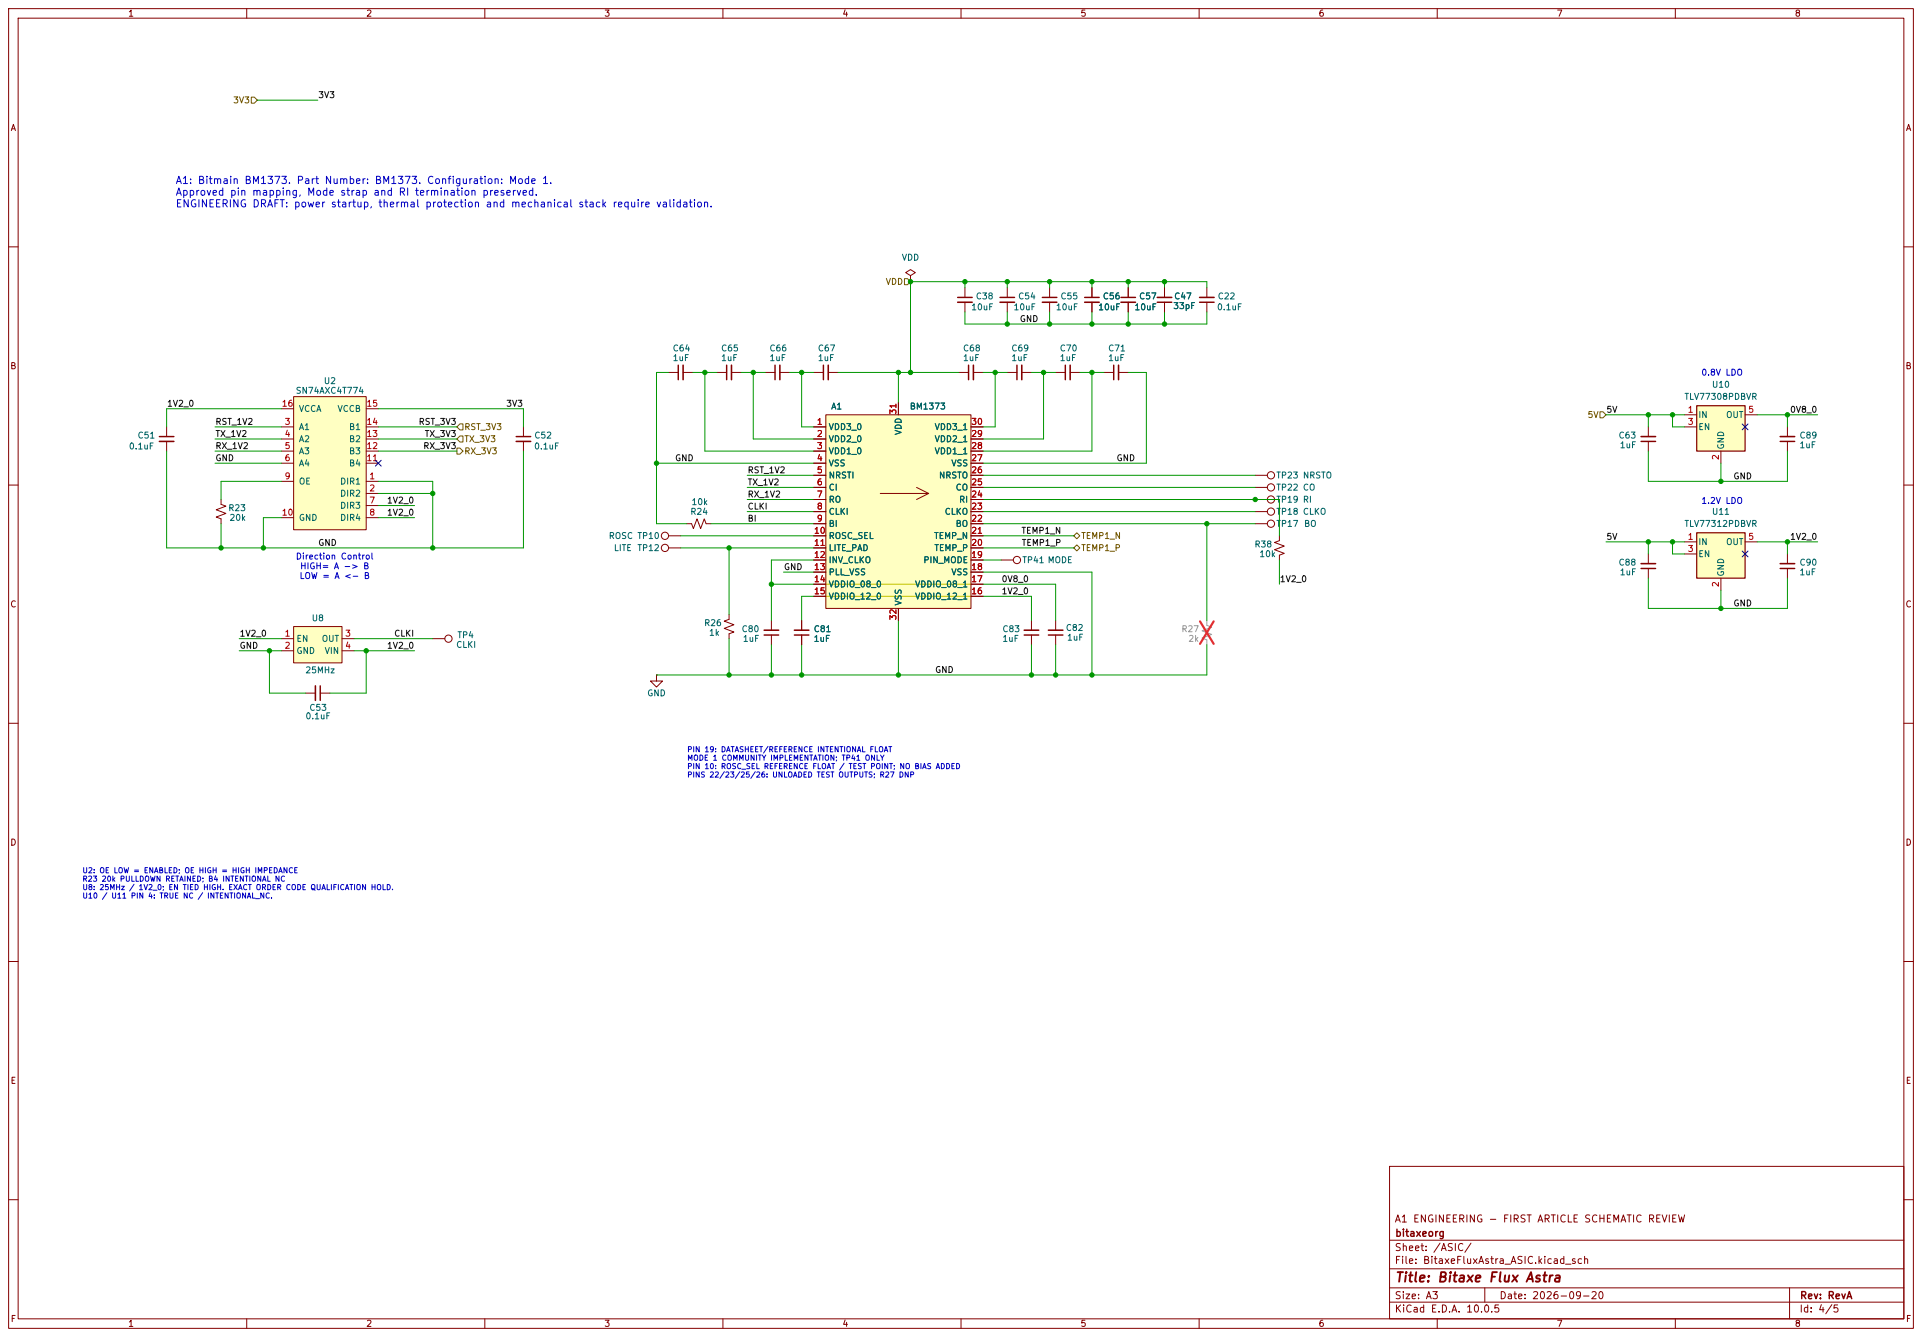
[picture p16: page 4]

A1: Bitmain BM1373. Part Number: BM1373. Configuration: Mode 1.
Approved pin mapping, Mode strap and RI termination preserved.

PINS 22/23/25/26: UNLOADED TEST OUTPUTS; R27 DNP

A1 ENGINEERING - FIRST ARTICLE SCHEMATIC REVIEW
bitaxeorg
Sheet: /ASIC/
File: BitaxeFluxAstra_ASIC.kicad_sch

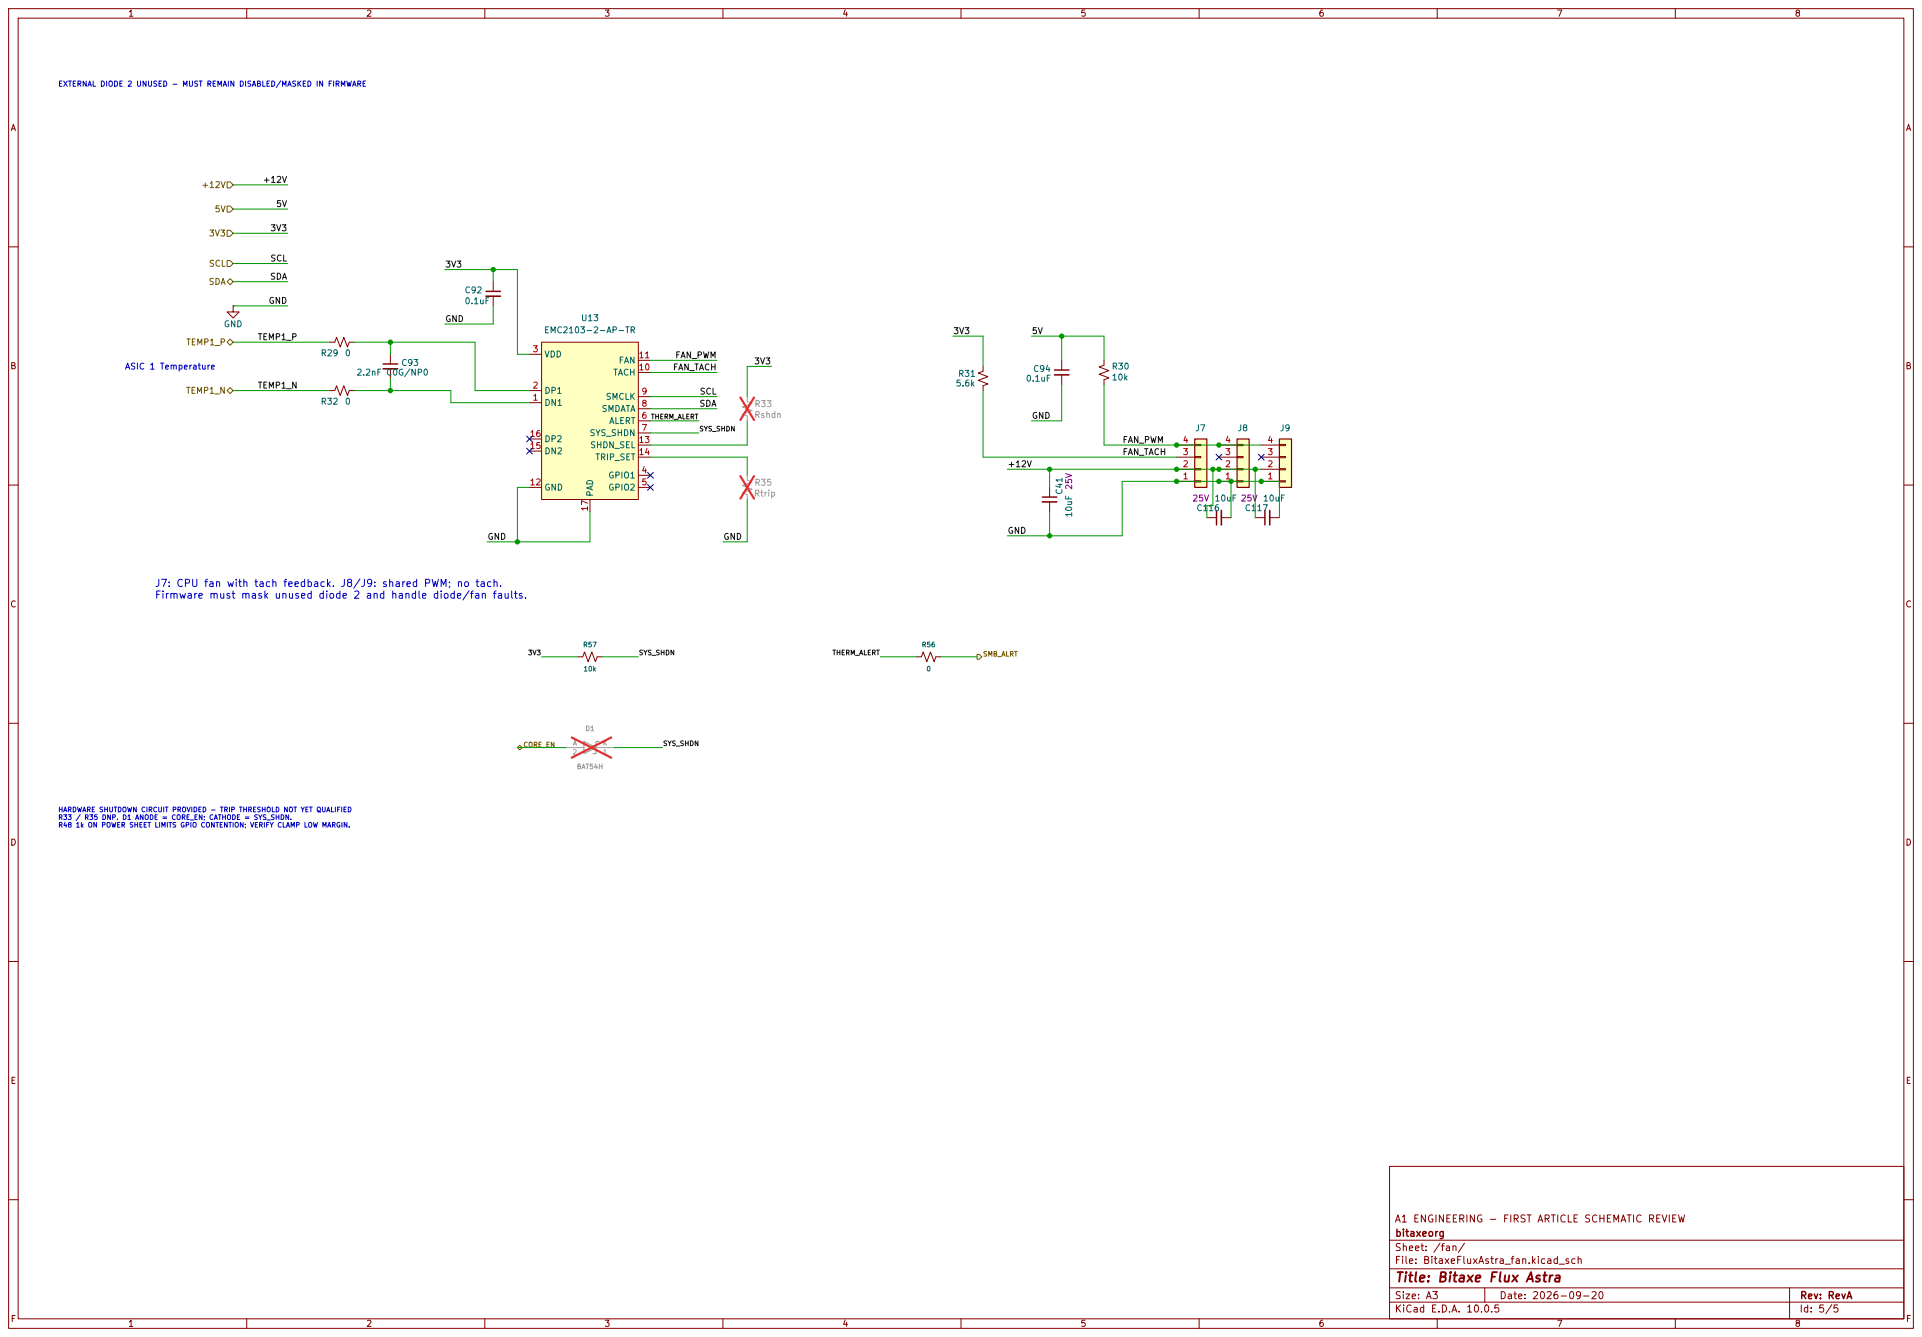
[picture p17: page 5]

EXTERNAL DIODE 2 UNUSED - MUST REMAIN DISABLED/MASKED IN FIRMWARE ASIC 1 Temperature

J7: CPU fan with tach feedback. J8/J9: shared PWM; no tach.
Firmware must mask unused diode 2 and handle diode/fan faults.

3V3 HARDWARE SHUTDOWN CIRCUIT PROVIDED - TRIP THRESHOLD NOT YET QUALIFIED

R33 / R35 DNP. D1 ANODE = CORE_EN; CATHODE = SYS_SHDN. R48 1k ON POWER SHEET LIMITS GPIO CONTENTION; VERIFY CLAMP LOW MARGIN.

A1 ENGINEERING - FIRST ARTICLE SCHEMATIC REVIEW
bitaxeorg
Sheet: /fan/
File: BitaxeFluxAstra_fan.kicad_sch
