Zayno/BitaxeFluxReview/_KiCad_Project/BitaxeFluxAstra.kicad_pcb

## KiCad design _KiCad_Project/BitaxeFluxAstra.kicad_pcb (2026-10-25)

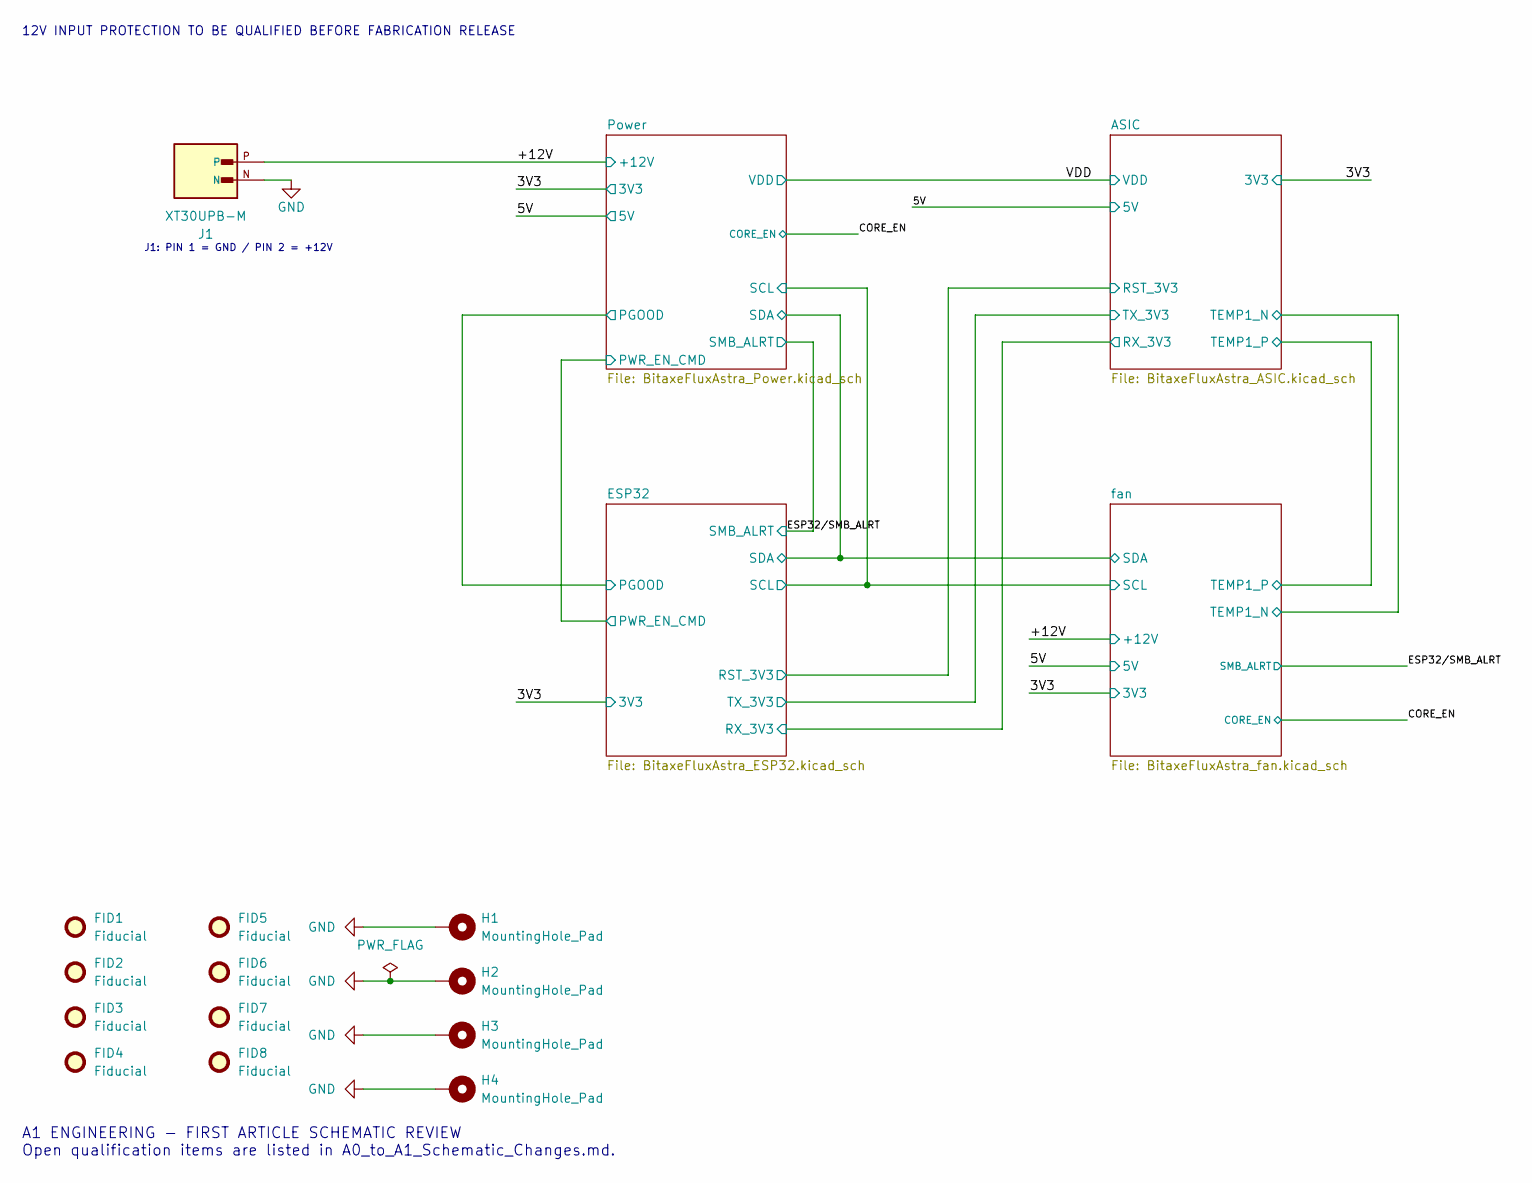
[picture p18: schematic BitaxeFluxAstra.kicad_sch, Bitaxe Flux Astra]

Parts:
FID1, FID2, FID3, FID4, FID5, FID6, FID7, FID8: Fiducial; Fiducial_1mm_Mask2mm
H1, H2, H3, H4: MountingHole_Pad; MountingHole_3.2mm_M3_Pad_Via
J1: XT30UPB-M; AMASS_XT30UPB-M

Connections:
+12V: J1.P; also elsewhere on the board
GND: H1.1 (1_1), H2.1 (1_1), H3.1 (1_1), H4.1 (1_1), J1.N; also elsewhere on the board

Notes on the sheet:
J1: PIN 1 = GND / PIN 2 = +12V
A1 ENGINEERING - FIRST ARTICLE SCHEMATIC REVIEW Open qualification items are listed in A0_to_A1_Schematic_Changes.md.
12V INPUT PROTECTION TO BE QUALIFIED BEFORE FABRICATION RELEASE

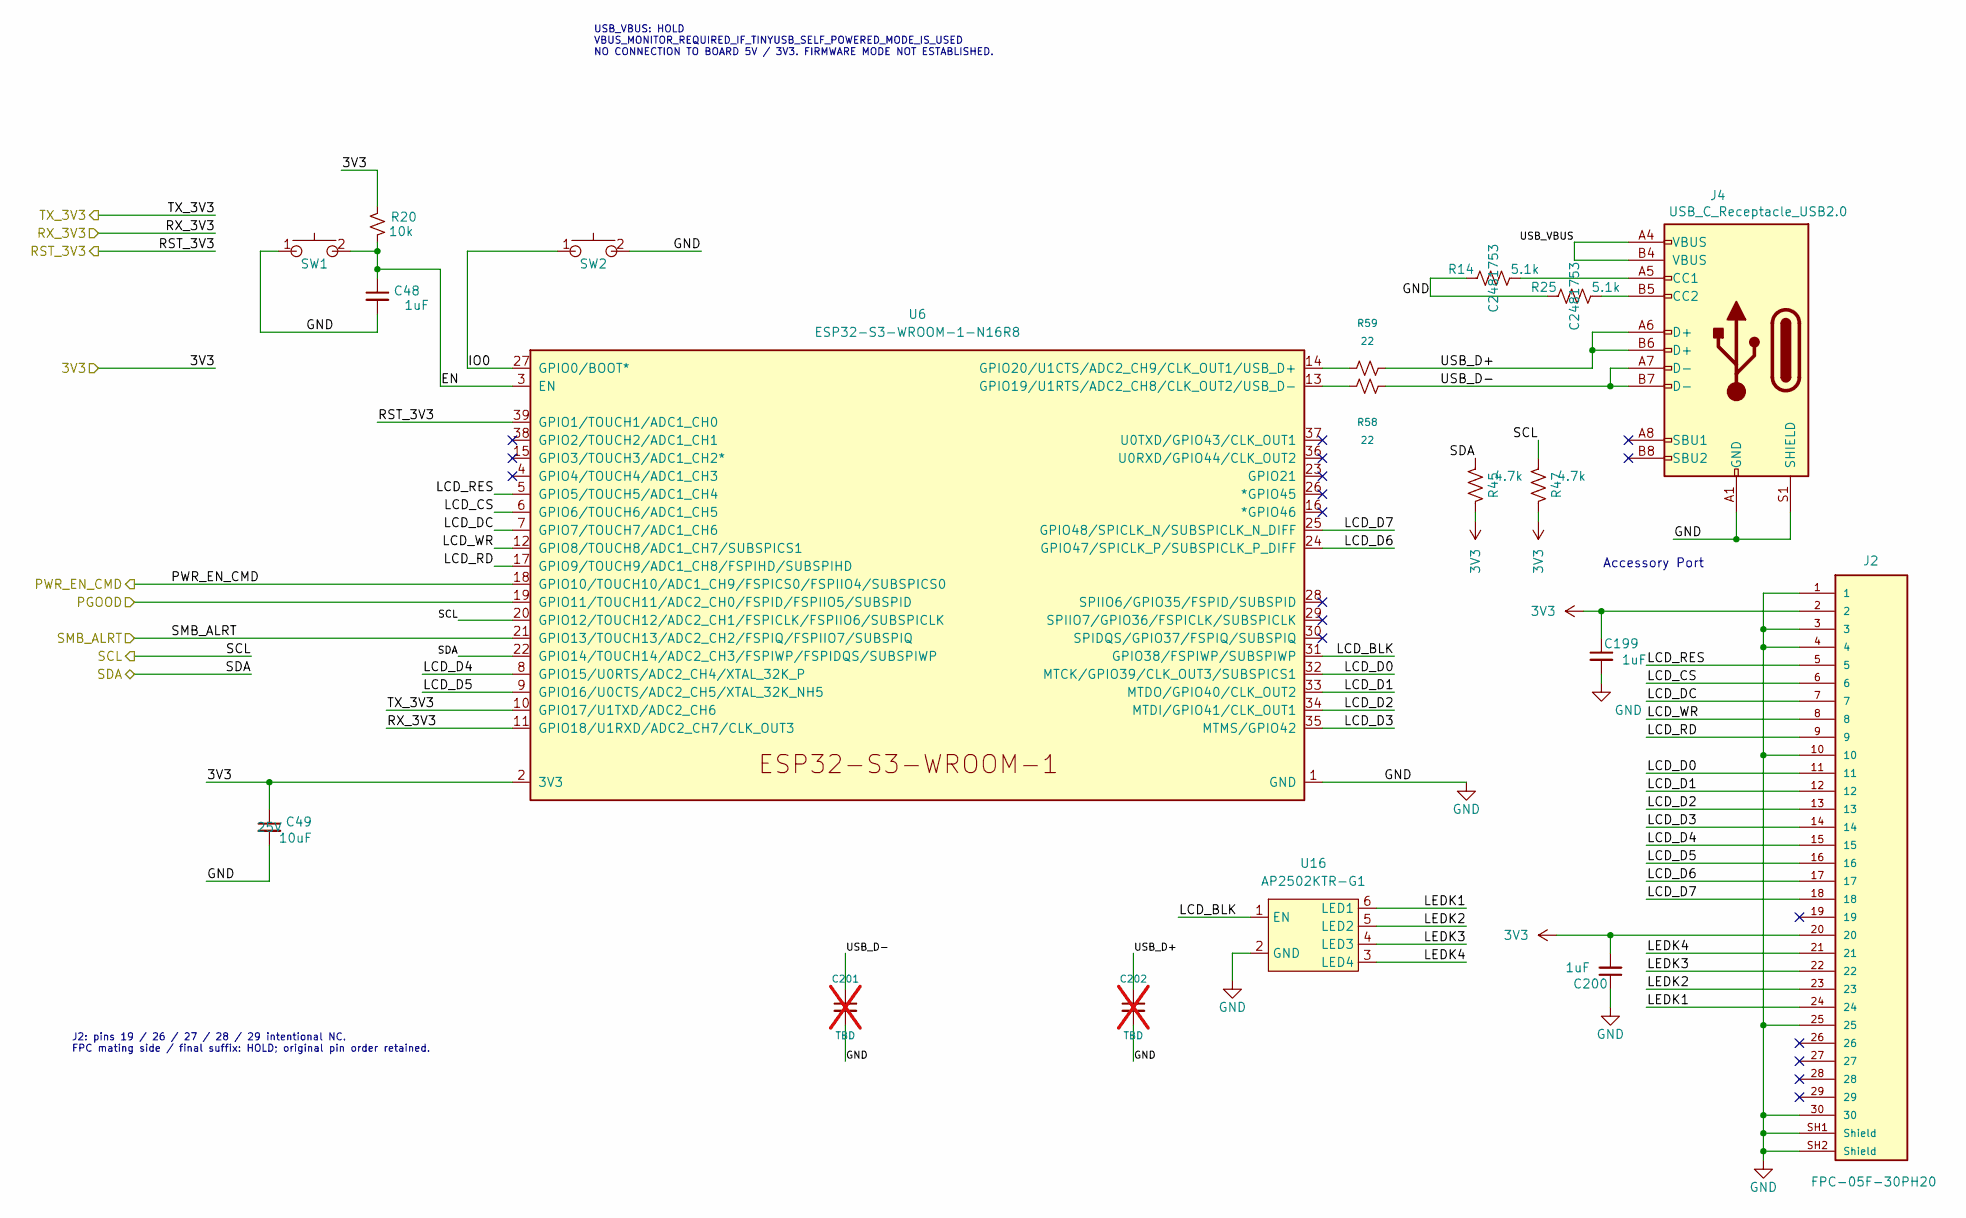
[picture p19: schematic BitaxeFluxAstra_ESP32.kicad_sch, Bitaxe Flux Astra]

Parts:
C48, C199, C200: 1uF; C_0603_1608Metric; PARTNO TMK107B7105KA-T
C49: 10uF; C_0603_1608Metric; Voltage 25V; PARTNO GRM188R61E106KA73D; LCSC C344022
C201, C202: TBD; C_0402_1005Metric; PARTNO TBD / QUALIFY; not fitted
J2: FPC-05F-30PH20; FPC-SMD_30P-P0.50_XUNPU_FPC-05F-30PH20; PARTNO FPC-05FB-30PH20
J4: USB_C_Receptacle_USB2.0; USB_C_Receptacle_GCT_USB4105-xx-A; PARTNO USB4105-GF-A
R14, R25: 5.1k; R_0402_1005Metric; PARTNO RMCF0402JT5K10; LCSC C2481753
R20: 10k; R_0402_1005Metric; PARTNO RC0402JR-0710KL; LCSC C25744
R45, R47: 4.7k; R_0402_1005Metric; PARTNO RC0402DR-074K7L; LCSC C471788
R58, R59: 22; R_0402_1005Metric; PARTNO RC0402FR-0722RL
SW1, SW2: SW_Push_SPST_NO; SW_CS1213AGF260_CRS; PARTNO CS1213AGF260
U6: ESP32-S3-WROOM-1-N16R8; ESP32-S3-WROOM-1; PARTNO ESP32-S3-WROOM-1-N16R8
U16: AP2502KTR-G1; SOT-23-6; PARTNO AP2502KTR-G1

Connections:
3V3: C49.1, C199.1, C200.2, J2.2, J2.20, R20.2, R45.1, R47.1, U6.2 (3V3); also elsewhere on the board
/ASIC/RST_3V3: U6.39 (GPIO1/TOUCH1/ADC1_CH0); also elsewhere on the board
/ASIC/RX_3V3: U6.11 (GPIO18/U1RXD/ADC2_CH7/CLK_OUT3); also elsewhere on the board
/ASIC/TX_3V3: U6.10 (GPIO17/U1TXD/ADC2_CH6); also elsewhere on the board
/ESP32/EN: C48.1, R20.1, SW1.2, U6.3 (EN)
/ESP32/IO0: SW2.1, U6.27 (GPIO0/BOOT*)
/ESP32/LCD_BLK: U6.31 (GPIO38/FSPIWP/SUBSPIWP), U16.1 (EN)
/ESP32/LCD_CS: J2.6, U6.6 (GPIO6/TOUCH6/ADC1_CH5)
/ESP32/LCD_D0: J2.11, U6.32 (MTCK/GPIO39/CLK_OUT3/SUBSPICS1)
/ESP32/LCD_D1: J2.12, U6.33 (MTDO/GPIO40/CLK_OUT2)
/ESP32/LCD_D2: J2.13, U6.34 (MTDI/GPIO41/CLK_OUT1)
/ESP32/LCD_D3: J2.14, U6.35 (MTMS/GPIO42)
/ESP32/LCD_D4: J2.15, U6.8 (GPIO15/U0RTS/ADC2_CH4/XTAL_32K_P)
/ESP32/LCD_D5: J2.16, U6.9 (GPIO16/U0CTS/ADC2_CH5/XTAL_32K_NH5)
/ESP32/LCD_D6: J2.17, U6.24 (GPIO47/SPICLK_P/SUBSPICLK_P_DIFF)
/ESP32/LCD_D7: J2.18, U6.25 (GPIO48/SPICLK_N/SUBSPICLK_N_DIFF)
/ESP32/LCD_DC: J2.7, U6.7 (GPIO7/TOUCH7/ADC1_CH6)
/ESP32/LCD_RD: J2.9, U6.17 (GPIO9/TOUCH9/ADC1_CH8/FSPIHD/SUBSPIHD)
/ESP32/LCD_RES: J2.5, U6.5 (GPIO5/TOUCH5/ADC1_CH4)
/ESP32/LCD_WR: J2.8, U6.12 (GPIO8/TOUCH8/ADC1_CH7/SUBSPICS1)
/ESP32/LEDK1: J2.24, U16.6 (LED1)
/ESP32/LEDK2: J2.23, U16.5 (LED2)
/ESP32/LEDK3: J2.22, U16.4 (LED3)
/ESP32/LEDK4: J2.21, U16.3 (LED4)
/ESP32/PWR_EN_CMD: U6.18 (GPIO10/TOUCH10/ADC1_CH9/FSPICS0/FSPIIO4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); also elsewhere on the board
/ESP32/SCL: R47.2, U6.20 (GPIO12/TOUCH12/ADC2_CH1/FSPICLK/FSPIIO6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); also elsewhere on the board
/ESP32/SDA: R45.2, U6.22 (GPIO14/TOUCH14/ADC2_CH3/FSPIWP/FSPIDQS/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); also elsewhere on the board
/ESP32/USB_D+: C202.1, J4.A6 (D+), J4.B6 (D+), R59.2
/ESP32/USB_D-: C201.1, J4.A7 (D-), J4.B7 (D-), R58.2
/ESP32/USB_VBUS: J4.A4 (VBUS), J4.B4 (VBUS)
/ESP32/SMB_ALRT: U6.21 (GPIO13/TOUCH13/ADC2_CH2/FSPIQ/FSPIIO7/S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); also elsewhere on the board
/Power/PGOOD: U6.19 (GPIO11/TOUCH11/ADC2_CH0/FSPID/FSPIIO5/S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); also elsewhere on the board
GND: C48.2, C49.2, C199.2, C200.1, C201.2, C202.2, J2.1, J2.3, J2.4, J2.10, J2.25, J2.30, J2.SH1 (Shield), J2.SH2 (Shield), J4.A1 (GND), J4.B1 (GND), J4.S1 (SHIELD), R14.1, R25.1, SW1.1, SW2.2, U6.1 (GND), U6.40 (GND), U6.41 (GND), U16.2 (GND); also elsewhere on the board
unnamed: J4.A5 (CC1), R14.2
unnamed: J4.B5 (CC2), R25.2
unnamed: R58.1, U6.13 (GPIO19/U1RTS/ADC2_CH8/CLK_OUT2/USB_D-)
unnamed: R59.1, U6.14 (GPIO20/U1CTS/ADC2_CH9/CLK_OUT1/USB_D+)

Notes on the sheet:
J2: pins 19 / 26 / 27 / 28 / 29 intentional NC. FPC mating side / final suffix: HOLD; original pin order retained.
USB_VBUS: HOLD VBUS_MONITOR_REQUIRED_IF_TINYUSB_SELF_POWERED_MODE_IS_USED NO CONNECTION TO BOARD 5V / 3V3. FIRMWARE MODE NOT ESTABLISHED.
Accessory Port

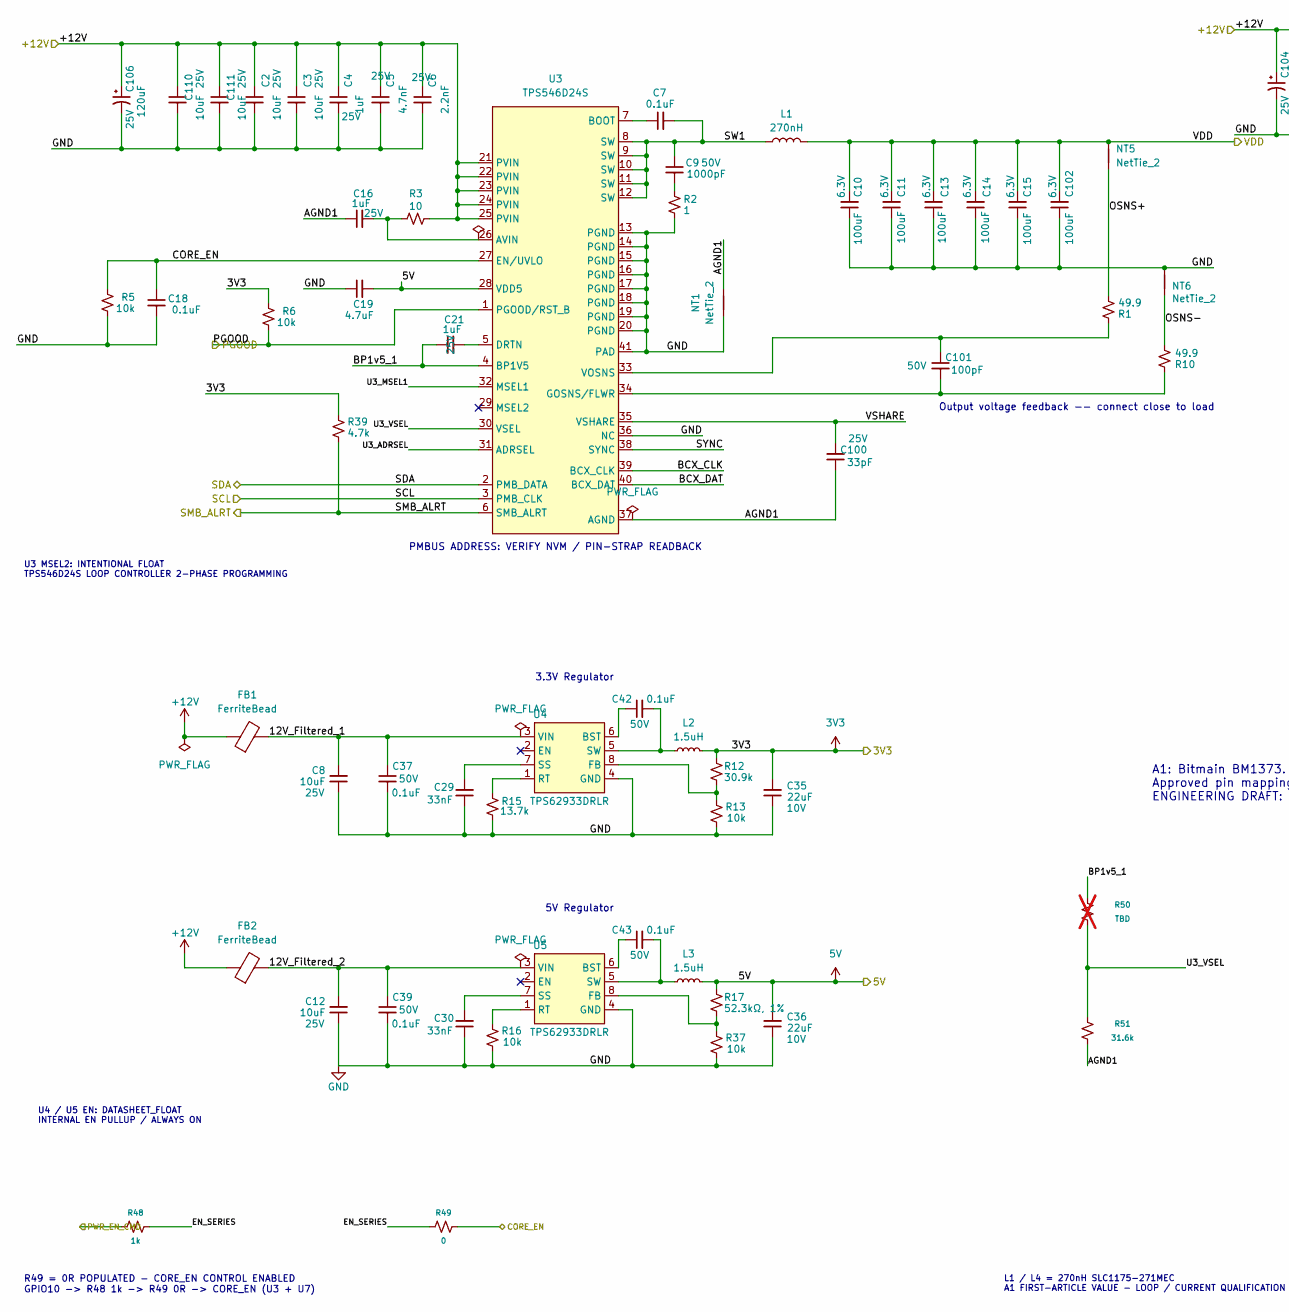
[picture p20: schematic BitaxeFluxAstra_Power.kicad_sch, Bitaxe Flux Astra, part in row 1, column 1]

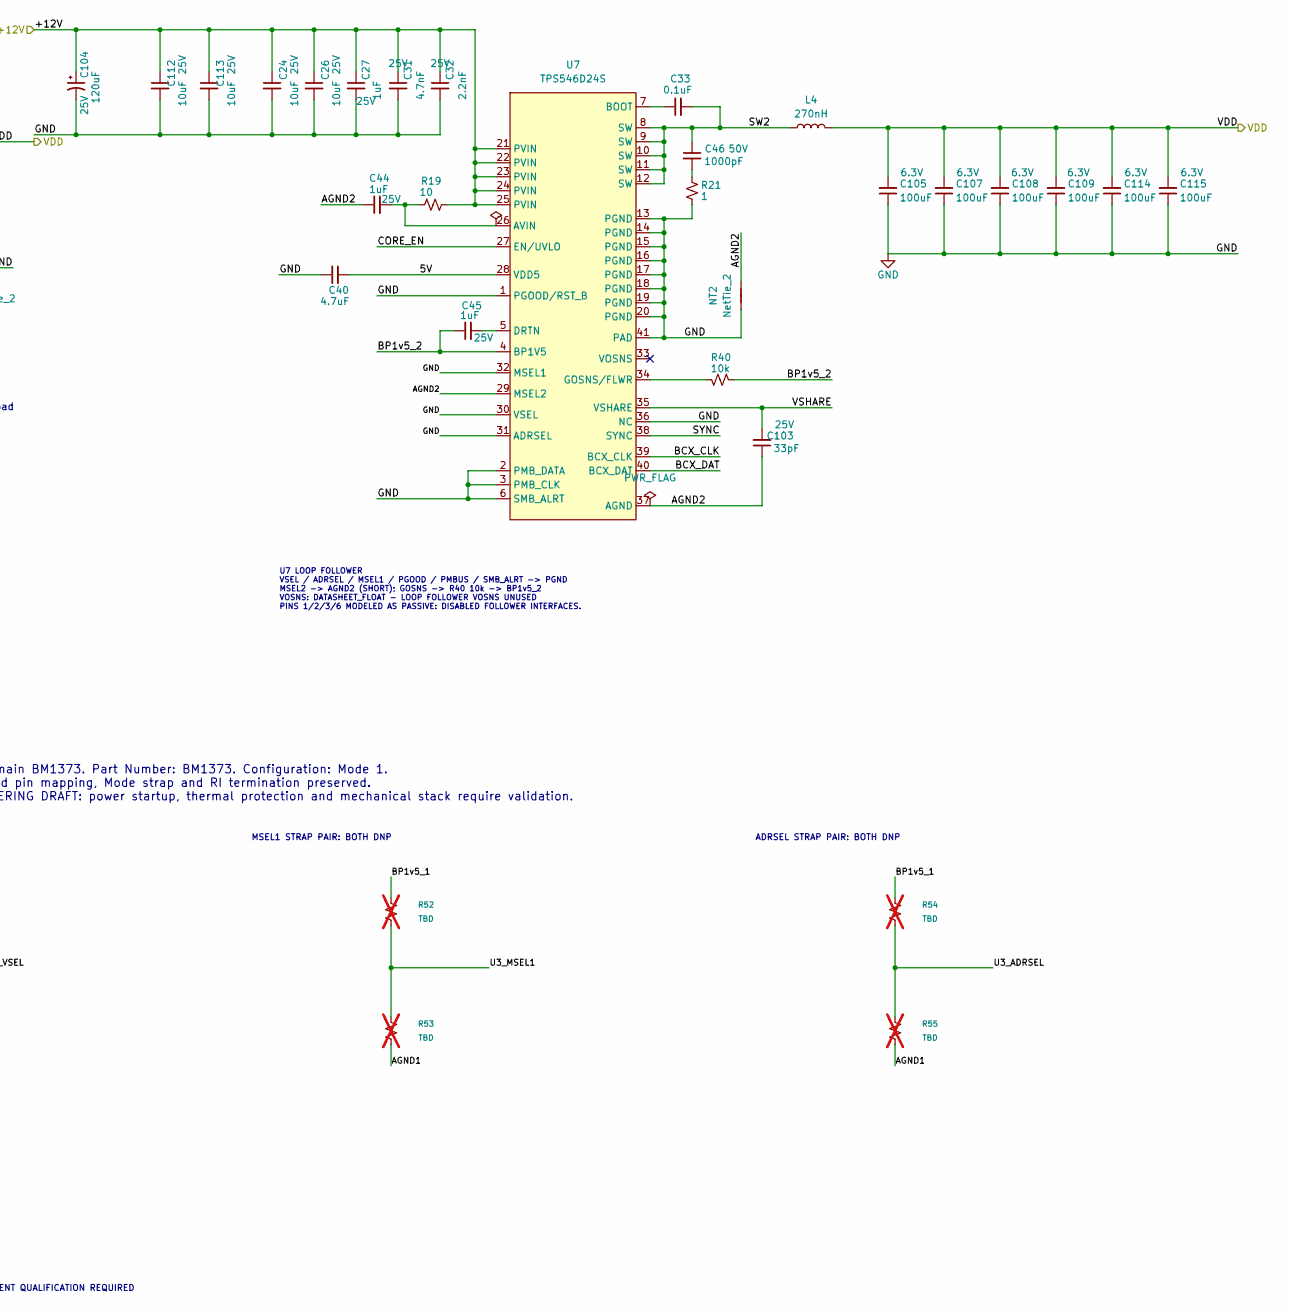
[picture p21: schematic BitaxeFluxAstra_Power.kicad_sch, Bitaxe Flux Astra, part in row 1, column 2]

Parts:
C2, C3, C24, C26, C110, C111, C112, C113: 10uF; C_0603_1608Metric; Voltage 25V; PARTNO GRM188R61E106KA73D
C4, C16, C21, C27, C44, C45: 1uF; C_0603_1608Metric; Voltage 25V; PARTNO TMK107B7105KA-T
C5, C31: 4.7nF; C_0402_1005Metric; Voltage 25V; PARTNO GRM155R71E472KA01D
C6, C32: 2.2nF; C_0402_1005Metric; Voltage 25V; PARTNO GRM155R61H222KA01D
C7, C18, C33: 0.1uF; C_0402_1005Metric; PARTNO KGM05AR71C104KH
C8, C12: 10uF; C_0603_1608Metric; Voltage 25V; PARTNO GRM188R61E106KA73D; LCSC C344022
C9, C46: 1000pF; C_0805_2012Metric; Voltage 50V; PARTNO CC0805KRX7R9BB102
C10, C11, C13, C14, C15, C102, C105, C107, C108, C109, C114, C115: 100uF; C_1206_3216Metric; Voltage 6.3V; PARTNO CL31A107MQHNNNE
C19, C40: 4.7uF; C_0402_1005Metric; PARTNO GRM155R61A475MEAAD
C29, C30: 33nF; C_0402_1005Metric; PARTNO CC0402KRX7R9BB333; LCSC C106862
C35, C36: 22uF; C_0805_2012Metric; Voltage 10V; PARTNO CL21A226MPQNNNE; LCSC C29277
C37, C39, C42, C43: 0.1uF; C_0402_1005Metric; Voltage 50V; PARTNO GRM155R71H104KE14D; LCSC C77020
C100, C103: 33pF; C_0402_1005Metric; Voltage 25V; PARTNO KGM05ACG1E330JH
C101: 100pF; C_0402_1005Metric; Voltage 50V; PARTNO CC0402JRNPO9BN101
C104, C106: 120uF; CP_Elec_6.3x5.9; Voltage 25V; PARTNO TBD / QUALIFY
FB1, FB2: FerriteBead; C_1206_3216Metric; PARTNO BLM31KN601SN1L
L1, L4: 270nH; SLC1175-271MEC_COC; PARTNO SLC1175-271MEC
L2, L3: 1.5uH; IND-SMD_L2.0-W1.6; PARTNO FTC201612S1R5MBCA; LCSC C5832350
NT1, NT2, NT5, NT6: NetTie_2; NetTie-2_SMD_Pad0.2mmx1mm
R1, R10: 49.9; R_0402_1005Metric; PARTNO RC0402FR-0749R9L
R2, R21: 1; R_0805_2012Metric; PARTNO ESR10EZPJ1R0
R3, R19: 10; R_0402_1005Metric; PARTNO RC0402FR-0710RL
R5, R6, R40: 10k; R_0402_1005Metric; PARTNO RC0402JR-0710KL
R12: 30.9k; R_0402_1005Metric; PARTNO RC0402FR-0730K9L; LCSC C185428
R13, R16: 10k; R_0402_1005Metric; PARTNO RC0402JR-0710KL; LCSC C25744
R15: 13.7k; R_0402_1005Metric; PARTNO RC0402FR-0713K7L; LCSC C274888
R17: 52.3kΩ, 1%; R_0402_1005Metric
R37: 10k; R_0402_1005Metric
R39: 4.7k; R_0402_1005Metric; PARTNO RC0402JR-074K7L
R48: 1k; R_0402_1005Metric; PARTNO RC0402FR-071KL
R49: 0; R_0402_1005Metric; PARTNO Yageo RC0402JR-070RL
R50, R52, R53, R54, R55: TBD; R_0402_1005Metric; PARTNO TBD / QUALIFY; not fitted
R51: 31.6k; R_0402_1005Metric
U3, U7: TPS546D24S; LQFN40-CLIP; PARTNO TPS546D24SRVFR
U4, U5: TPS62933DRLR; SOT-583-8_L2.1-W1.2-P0.50-LS1.6-BR; PARTNO TPS62933DRLR; LCSC C3200405

Connections:
3V3: C35.2, L2.2, R6.2, R12.2, R39.1; also elsewhere on the board
+12V: C2.1, C3.1, C4.1, C5.1, C6.1, C24.1, C26.1, C27.1, C31.1, C32.1, C104.1, C106.1, C110.1, C111.1, C112.1, C113.1, FB1.1, FB2.1, R3.1, R19.1, U3.21 (PVIN), U3.22 (PVIN), U3.23 (PVIN), U3.24 (PVIN), U3.25 (PVIN), U7.21 (PVIN), U7.22 (PVIN), U7.23 (PVIN), U7.24 (PVIN), U7.25 (PVIN); also elsewhere on the board
/5V: C19.2, C36.2, C40.2, L3.2, R17.2, U3.28 (VDD5), U7.28 (VDD5); also elsewhere on the board
/CORE_EN: C18.1, R5.2, R49.2, U3.27 (EN/UVLO), U7.27 (EN/UVLO); also elsewhere on the board
/ESP32/PWR_EN_CMD: R48.1; also elsewhere on the board
/ESP32/SCL: U3.3 (PMB_CLK); also elsewhere on the board
/ESP32/SDA: U3.2 (PMB_DATA); also elsewhere on the board
/ESP32/SMB_ALRT: R39.2, U3.6 (SMB_ALRT); also elsewhere on the board
/Power/12V_Filtered_1: C8.2, C37.1, FB1.2, U4.3 (VIN)
/Power/12V_Filtered_2: C12.2, C39.1, FB2.2, U5.3 (VIN)
/Power/AGND1: C16.1, C100.1, NT1.2, R51.2, R53.2, R55.2, U3.37 (AGND)
/Power/AGND2: C44.1, C103.1, NT2.2, U7.29 (MSEL2), U7.37 (AGND)
/Power/BCX_CLK: U3.39 (BCX_CLK), U7.39 (BCX_CLK)
/Power/BCX_DAT: U3.40 (BCX_DAT), U7.40 (BCX_DAT)
/Power/BP1v5_1: C21.1, R50.1, R52.1, R54.1, U3.4 (BP1V5)
/Power/BP1v5_2: C45.1, R40.1, U7.4 (BP1V5)
/Power/EN_SERIES: R48.2, R49.1
/Power/OSNS+: NT5.1, R1.2
/Power/OSNS-: NT6.1, R10.1
/Power/PGOOD: R6.1, U3.1 (PGOOD/RST_B); also elsewhere on the board
/Power/SW1: C7.2, C9.1, L1.1, U3.8 (SW), U3.9 (SW), U3.10 (SW), U3.11 (SW), U3.12 (SW)
/Power/SW2: C33.2, C46.1, L4.1, U7.8 (SW), U7.9 (SW), U7.10 (SW), U7.11 (SW), U7.12 (SW)
/Power/SYNC: U3.38 (SYNC), U7.38 (SYNC)
/Power/U3_ADRSEL: R54.2, R55.1, U3.31 (ADRSEL)
/Power/U3_MSEL1: R52.2, R53.1, U3.32 (MSEL1)
/Power/U3_VSEL: R50.2, R51.1, U3.30 (VSEL)
/Power/VSHARE: C100.2, C103.2, U3.35 (VSHARE), U7.35 (VSHARE)
/VDD: C10.2, C11.2, C13.2, C14.2, C15.2, C102.2, C105.2, C107.2, C108.2, C109.2, C114.2, C115.2, L1.2, L4.2, NT5.2; also elsewhere on the board
GND: C2.2, C3.2, C4.2, C5.2, C6.2, C8.1, C10.1, C11.1, C12.1, C13.1, C14.1, C15.1, C18.2, C19.1, C24.2, C26.2, C27.2, C29.1, C30.1, C31.2, C32.2, C35.1, C36.1, C37.2, C39.2, C40.1, C102.1, C104.2, C105.1, C106.2, C107.1, C108.1, C109.1, C110.2, C111.2, C112.2, C113.2, C114.1, C115.1, NT1.1, NT2.1, NT6.2, R2.2, R5.1, R13.1, R15.1, R16.1, R21.2, R37.1, U3.13 (PGND), U3.14 (PGND), U3.15 (PGND), U3.16 (PGND), U3.17 (PGND), U3.18 (PGND), U3.19 (PGND), U3.20 (PGND), U3.36 (NC), U3.41 (PAD), U4.4 (GND), U5.4 (GND), U7.1 (PGOOD/RST_B), U7.2 (PMB_DATA), U7.3 (PMB_CLK), U7.6 (SMB_ALRT), U7.13 (PGND), U7.14 (PGND), U7.15 (PGND), U7.16 (PGND), U7.17 (PGND), U7.18 (PGND), U7.19 (PGND), U7.20 (PGND), U7.30 (VSEL), U7.31 (ADRSEL), U7.32 (MSEL1), U7.36 (NC), U7.41 (PAD); also elsewhere on the board
unnamed: C9.2, R2.1
unnamed: C46.2, R21.1
unnamed: C16.2, R3.2, U3.26 (AVIN)
unnamed: C7.1, U3.7 (BOOT)
unnamed: C21.2, U3.5 (DRTN)
unnamed: C101.2, R10.2, U3.34 (GOSNS/FLWR)
unnamed: C101.1, R1.1, U3.33 (VOSNS)
unnamed: C42.1, U4.6 (BST)
unnamed: R12.1, R13.2, U4.8 (FB)
unnamed: R15.2, U4.1 (RT)
unnamed: C29.2, U4.7 (SS)
unnamed: C42.2, L2.1, U4.5 (SW)
unnamed: C43.1, U5.6 (BST)
unnamed: R17.1, R37.2, U5.8 (FB)
unnamed: R16.2, U5.1 (RT)
unnamed: C30.2, U5.7 (SS)
unnamed: C43.2, L3.1, U5.5 (SW)
unnamed: C44.2, R19.2, U7.26 (AVIN)
unnamed: C33.1, U7.7 (BOOT)
unnamed: C45.2, U7.5 (DRTN)
unnamed: R40.2, U7.34 (GOSNS/FLWR)

Notes on the sheet:
ADRSEL STRAP PAIR: BOTH DNP
Output voltage feedback -- connect close to load
L1 / L4 = 270nH SLC1175-271MEC A1 FIRST-ARTICLE VALUE - LOOP / CURRENT QUALIFICATION REQUIRED
MSEL1 STRAP PAIR: BOTH DNP
A1: Bitmain BM1373. Part Number: BM1373. Configuration: Mode 1. Approved pin mapping, Mode strap and RI termination preserved. ENGINEERING DRAFT: power startup, thermal protection and mechanical stack require validation.
R49 = 0R POPULATED - CORE_EN CONTROL ENABLED GPIO10 -> R48 1k -> R49 0R -> CORE_EN (U3 + U7)
U7 LOOP FOLLOWER VSEL / ADRSEL / MSEL1 / PGOOD / PMBUS / SMB_ALRT -> PGND MSEL2 -> AGND2 (SHORT); GOSNS -> R40 10k -> BP1v5_2 VOSNS: DATASHEET_FLOAT - LOOP FOLLOWER VOSNS UNUSED PINS 1/2/3/6 MODELED AS PASSIVE: DISABLED FOLLOWER INTERFACES.
U4 / U5 EN: DATASHEET_FLOAT INTERNAL EN PULLUP / ALWAYS ON
PMBUS ADDRESS: VERIFY NVM / PIN-STRAP READBACK
5V Regulator
U3 MSEL2: INTENTIONAL FLOAT TPS546D24S LOOP CONTROLLER 2-PHASE PROGRAMMING
3.3V Regulator

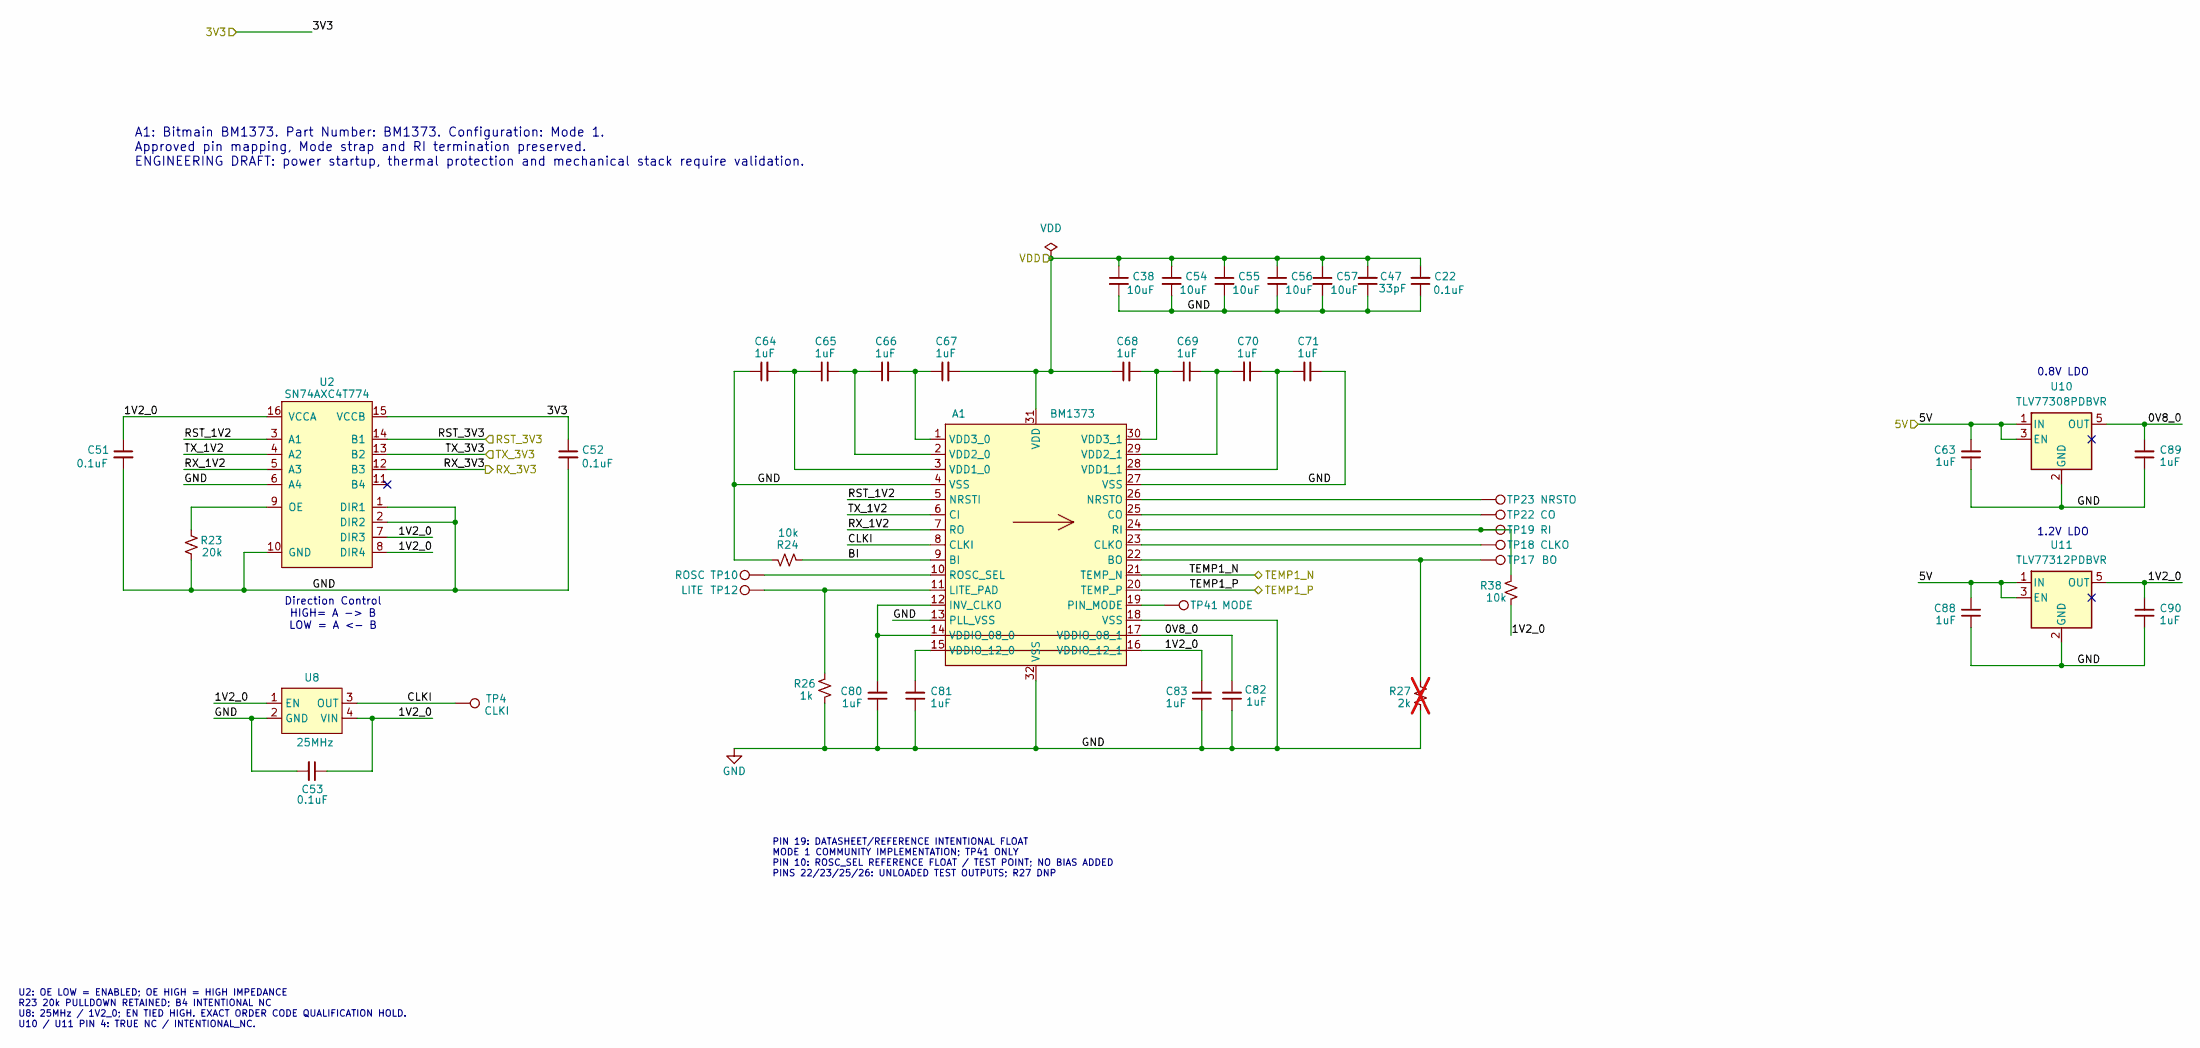
[picture p22: schematic BitaxeFluxAstra_ASIC.kicad_sch, Bitaxe Flux Astra]

Parts:
A1: BM1373; PARTNO BM1373
C22: 0.1uF; C_0402_1005Metric; PARTNO GRM155R71H104KE14D; LCSC C77020
C38, C54, C55, C56, C57: 10uF; C_0603_1608Metric; Voltage 25V; PARTNO GRM188R61E106KA73D; LCSC C344022
C47: 33pF; C_0402_1005Metric; Voltage 25V; PARTNO KGM05ACG1E330JH
C51, C52, C53: 0.1uF; C_0402_1005Metric; PARTNO KGM05AR71C104KH
C63, C64, C65, C66, C67, C68, C69, C70, C71, C80, C81, C82, C83, C88, C89, C90: 1uF; C_0402_1005Metric; PARTNO EMK105BJ105MV-F; LCSC C2177690
R23: 20k; R_0402_1005Metric; PARTNO RC0402FR-0720KL
R24: 10k; R_0402_1005Metric; PARTNO RC0402JR-0710KL; LCSC C25744
R26: 1k; R_0402_1005Metric; PARTNO RC0402FR-071KL
R27: 2k; R_0402_1005Metric; PARTNO RT0402BRD072KL; not fitted
R38: 10k; R_0402_1005Metric; PARTNO RC0402JR-0710KL
TP4: CLKI; TestPoint_Pad_D1.0mm
TP10: ROSC; TestPoint_Pad_1.0x0.4mm
TP12: LITE; TestPoint_Pad_1.0x0.4mm
TP17: BO; TestPoint_Pad_1.0x0.4mm
TP18: CLKO; TestPoint_Pad_1.0x0.4mm
TP19: RI; TestPoint_Pad_1.0x0.4mm
TP22: CO; TestPoint_Pad_1.0x0.4mm
TP23: NRSTO; TestPoint_Pad_1.0x0.4mm
TP41: MODE; TestPoint_Pad_1.0x0.4mm
U2: SN74AXC4T774; TSSOP-16_4.4x5mm_P0.65mm; PARTNO SN74AXC4T774PWR; LCSC C1849453
U8: 25MHz; SMD3225-4P; PARTNO SX3M25.000E20F30THN; LCSC C5137262
U10: TLV77308PDBVR; SOT-23-5; PARTNO TLV77308PDBVR
U11: TLV77312PDBVR; SOT-23-5; PARTNO TLV77312PDBVR

Connections:
3V3: C52.1, U2.15 (VCCB); also elsewhere on the board
/5V: C63.2, C88.2, U10.1 (IN), U10.3 (EN), U11.1 (IN), U11.3 (EN); also elsewhere on the board
/ASIC/BI: A1.9 (BI), R24.2
/ASIC/CLKI: A1.8 (CLKI), TP4.1 (1_1), U8.3 (OUT)
/ASIC/RST_1V2: A1.5 (NRSTI), U2.3 (A1)
/ASIC/RST_3V3: U2.14 (B1); also elsewhere on the board
/ASIC/RX_1V2: A1.7 (RO), U2.5 (A3)
/ASIC/RX_3V3: U2.12 (B3); also elsewhere on the board
/ASIC/TEMP1_N: A1.21 (TEMP_N); also elsewhere on the board
/ASIC/TEMP1_P: A1.20 (TEMP_P); also elsewhere on the board
/ASIC/TX_1V2: A1.6 (CI), U2.4 (A2)
/ASIC/TX_3V3: U2.13 (B2); also elsewhere on the board
/VDD: A1.31 (VDD), C22.2, C38.1, C47.2, C54.1, C55.1, C56.1, C57.1, C67.2, C68.1; also elsewhere on the board
GND: A1.4 (VSS), A1.13 (PLL_VSS), A1.18 (VSS), A1.27 (VSS), A1.32 (VSS), C22.1, C38.2, C47.1, C51.2, C52.2, C53.2, C54.2, C55.2, C56.2, C57.2, C63.1, C64.1, C71.2, C80.1, C81.1, C82.1, C83.1, C88.1, C89.1, C90.1, R23.1, R24.1, R26.1, R27.1, U2.1 (DIR1), U2.2 (DIR2), U2.6 (A4), U2.10 (GND), U8.2 (GND), U10.2 (GND), U11.2 (GND); also elsewhere on the board
unnamed: A1.22 (BO), R27.2, TP17.1 (1_1)
unnamed: A1.23 (CLKO), TP18.1 (1_1)
unnamed: A1.25 (CO), TP22.1 (1_1)
unnamed: A1.11 (LITE_PAD), R26.2, TP12.1 (1_1)
unnamed: A1.26 (NRSTO), TP23.1 (1_1)
unnamed: A1.19 (PIN_MODE), TP41.1 (1_1)
unnamed: A1.24 (RI), R38.2, TP19.1 (1_1)
unnamed: A1.10 (ROSC_SEL), TP10.1 (1_1)
unnamed: A1.3 (VDD1_0), C64.2, C65.1
unnamed: A1.28 (VDD1_1), C70.2, C71.1
unnamed: A1.2 (VDD2_0), C65.2, C66.1
unnamed: A1.29 (VDD2_1), C69.2, C70.1
unnamed: A1.1 (VDD3_0), C66.2, C67.1
unnamed: A1.30 (VDD3_1), C68.2, C69.1
unnamed: R23.2, U2.9 (OE)

Notes on the sheet:
1.2V LDO
U2: OE LOW = ENABLED; OE HIGH = HIGH IMPEDANCE R23 20k PULLDOWN RETAINED; B4 INTENTIONAL NC U8: 25MHz / 1V2_0; EN TIED HIGH. EXACT ORDER CODE QUALIFICATION HOLD. U10 / U11 PIN 4: TRUE NC / INTENTIONAL_NC.
PIN 19: DATASHEET/REFERENCE INTENTIONAL FLOAT MODE 1 COMMUNITY IMPLEMENTATION; TP41 ONLY PIN 10: ROSC_SEL REFERENCE FLOAT / TEST POINT; NO BIAS ADDED PINS 22/23/25/26: UNLOADED TEST OUTPUTS; R27 DNP
0.8V LDO
A1: Bitmain BM1373. Part Number: BM1373. Configuration: Mode 1. Approved pin mapping, Mode strap and RI termination preserved. ENGINEERING DRAFT: power startup, thermal protection and mechanical stack require validation.
Direction Control HIGH= A -> B LOW = A <- B

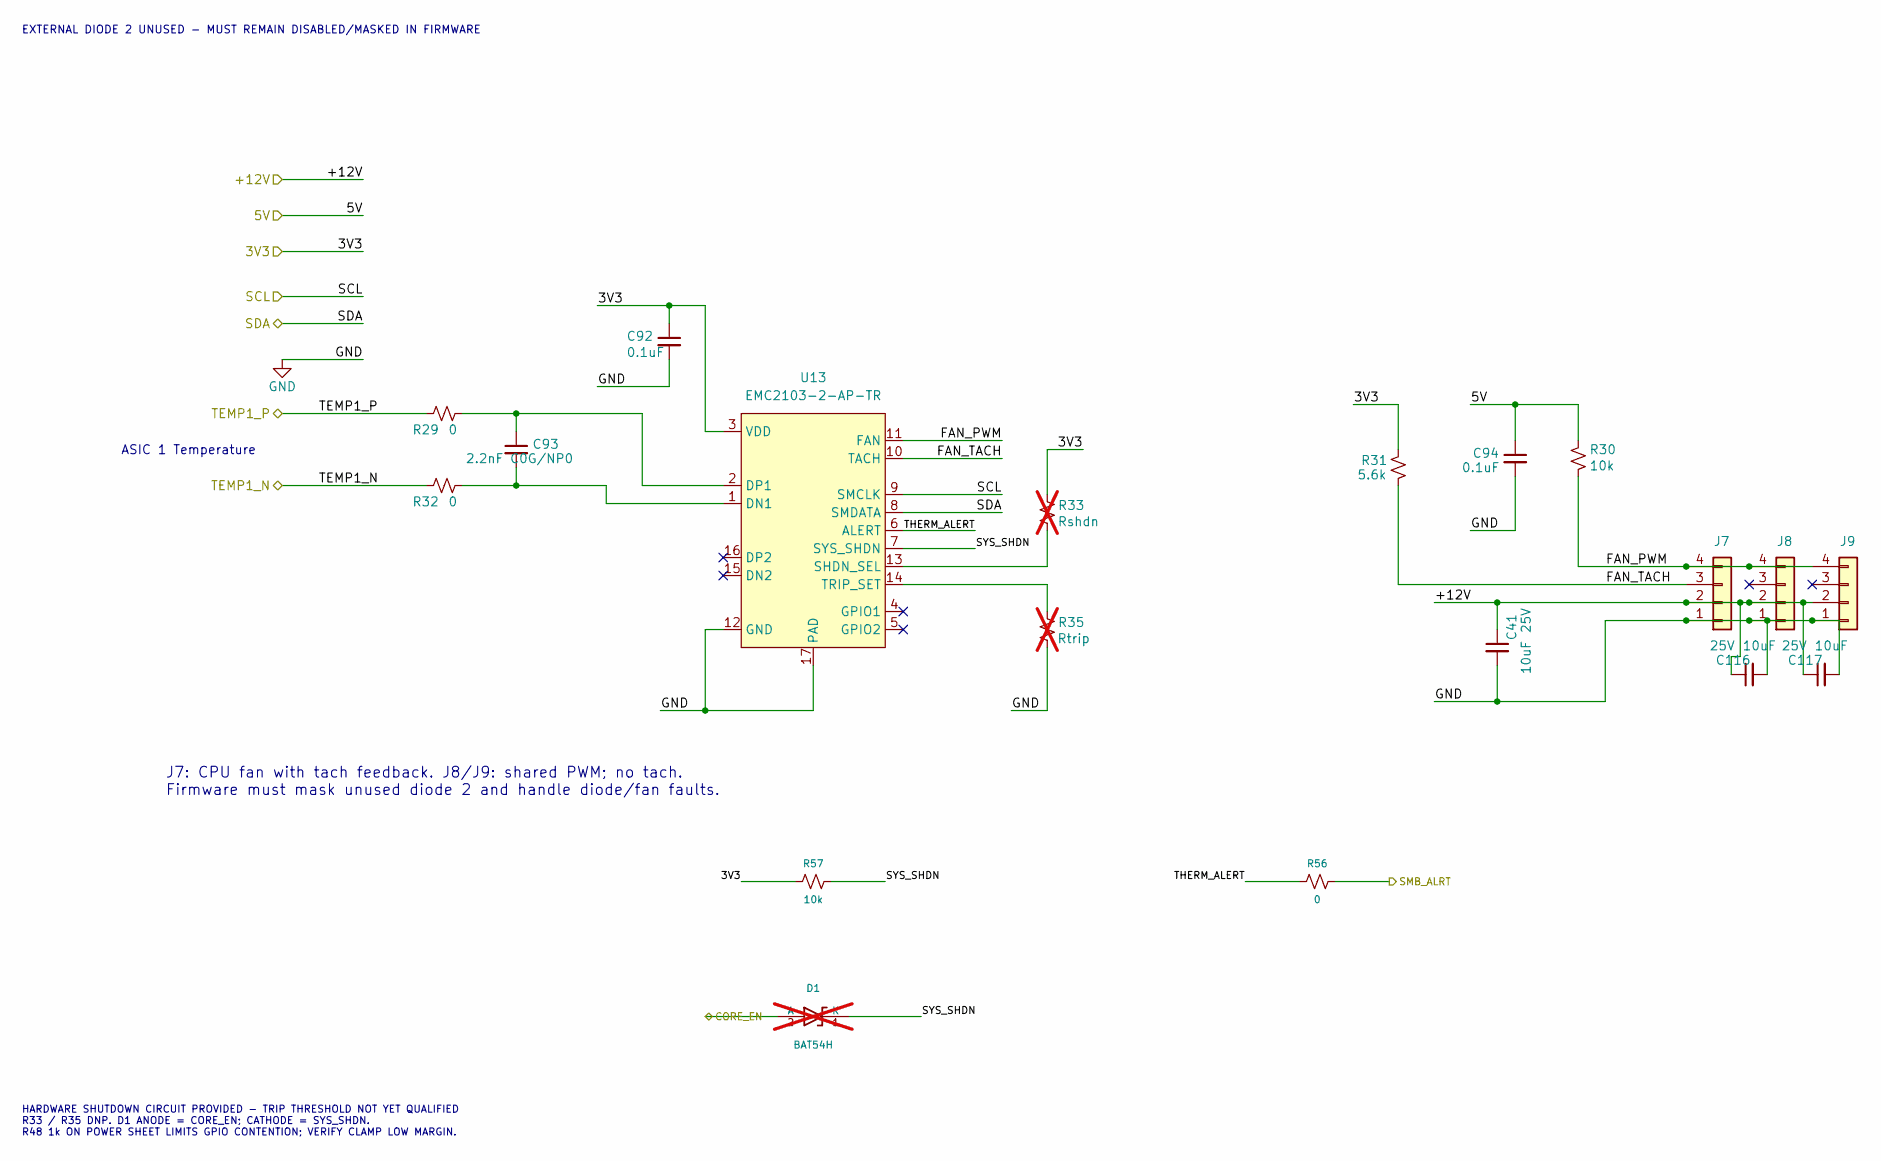
[picture p23: schematic BitaxeFluxAstra_fan.kicad_sch, Bitaxe Flux Astra]

Parts:
C41, C116, C117: 10uF; C_0603_1608Metric; Voltage 25V; PARTNO GRM188R61E106KA73D; LCSC C344022
C92, C94: 0.1uF; C_0402_1005Metric; PARTNO KGM05AR71C104KH
C93: 2.2nF C0G/NP0; C_0402_1005Metric; PARTNO TBD / QUALIFY
D1: BAT54H; D_SOD-123F; PARTNO BAT54H,115; not fitted
J7, J8, J9: Conn_01x04; 470531000; PARTNO 0470531000
R29, R32, R56: 0; R_0402_1005Metric; PARTNO RC0402JR-070RL
R30: 10k; R_0402_1005Metric; PARTNO RC0402JR-0710KL; LCSC C25744
R31: 5.6k; R_0402_1005Metric; PARTNO RC0402FR-075K6L
R33: Rshdn; R_0402_1005Metric; PARTNO TBD / QUALIFY; not fitted
R35: Rtrip; R_0402_1005Metric; PARTNO TBD / QUALIFY; not fitted
R57: 10k; R_0402_1005Metric; PARTNO RC0402JR-0710KL
U13: EMC2103-2-AP-TR; QFN-16-1EP_4x4mm_P0.65mm_EP2.1x2.1mm; PARTNO EMC2103-2-AP-TR

Connections:
3V3: C92.1, R31.2, R33.2, R57.1, U13.3 (VDD); also elsewhere on the board
+12V: C41.1, C116.1, C117.1, J7.2, J8.2, J9.2; also elsewhere on the board
/5V: C94.1, R30.2; also elsewhere on the board
/ASIC/TEMP1_N: R32.2; also elsewhere on the board
/ASIC/TEMP1_P: R29.2; also elsewhere on the board
/CORE_EN: D1.2 (A); also elsewhere on the board
/ESP32/SCL: U13.9 (SMCLK); also elsewhere on the board
/ESP32/SDA: U13.8 (SMDATA); also elsewhere on the board
/ESP32/SMB_ALRT: R56.2; also elsewhere on the board
/fan/FAN_PWM: J7.4, J8.4, J9.4, R30.1, U13.11 (FAN)
/fan/FAN_TACH: J7.3, R31.1, U13.10 (TACH)
/fan/SYS_SHDN: D1.1 (K), R57.2, U13.7 (SYS_SHDN)
/fan/THERM_ALERT: R56.1, U13.6 (ALERT)
GND: C41.2, C92.2, C94.2, C116.2, C117.2, J7.1, J8.1, J9.1, R35.1, U13.12 (GND), U13.17 (PAD); also elsewhere on the board
unnamed: C93.2, R32.1, U13.1 (DN1)
unnamed: C93.1, R29.1, U13.2 (DP1)
unnamed: R33.1, U13.13 (SHDN_SEL)
unnamed: R35.2, U13.14 (TRIP_SET)

Notes on the sheet:
J7: CPU fan with tach feedback. J8/J9: shared PWM; no tach. Firmware must mask unused diode 2 and handle diode/fan faults.
EXTERNAL DIODE 2 UNUSED - MUST REMAIN DISABLED/MASKED IN FIRMWARE
ASIC 1 Temperature
HARDWARE SHUTDOWN CIRCUIT PROVIDED - TRIP THRESHOLD NOT YET QUALIFIED R33 / R35 DNP. D1 ANODE = CORE_EN; CATHODE = SYS_SHDN. R48 1k ON POWER SHEET LIMITS GPIO CONTENTION; VERIFY CLAMP LOW MARGIN.

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
