Zayno/BitaxeFluxReview/_KiCad_Project/BitaxeFluxAstra.kicad_pcb

## KiCad design _KiCad_Project/BitaxeFluxAstra.kicad_pcb (continued)

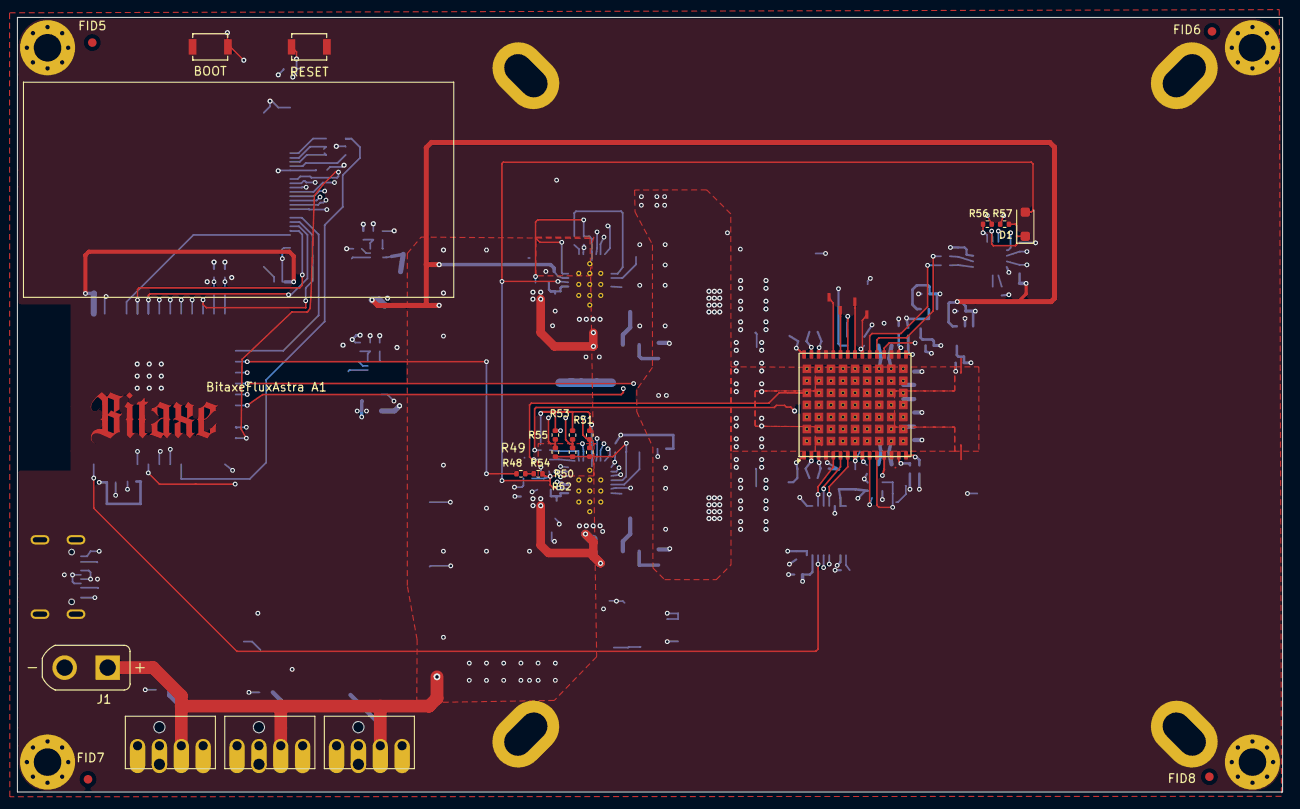
[picture p24: board BitaxeFluxAstra.kicad_pcb from above]

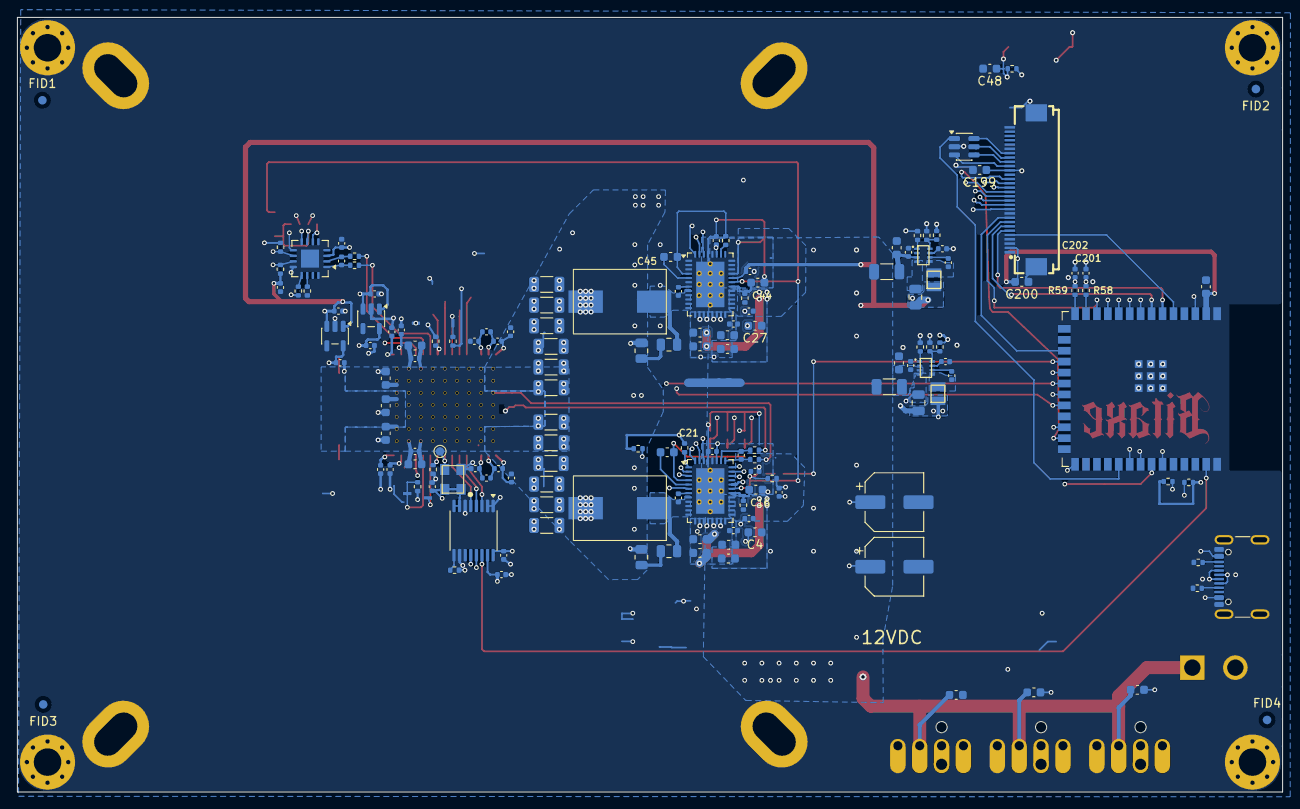
[picture p25: board BitaxeFluxAstra.kicad_pcb from below]

Board: 6 copper layers, 147.0 x 90.0 mm, 186 parts (154 on the bottom side), 112 nets.
